Shitovdm/diploma/images/board.png

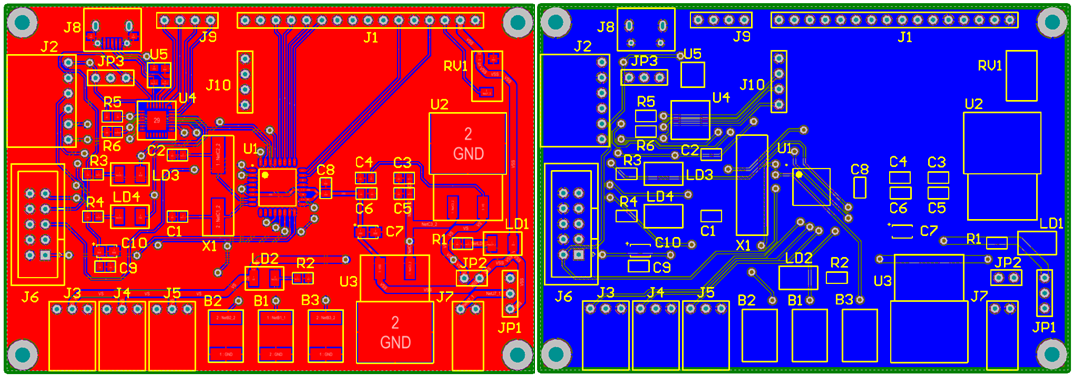
images/board.png
