Shitovdm/diploma/images/hardware/IMG_0107.JPG

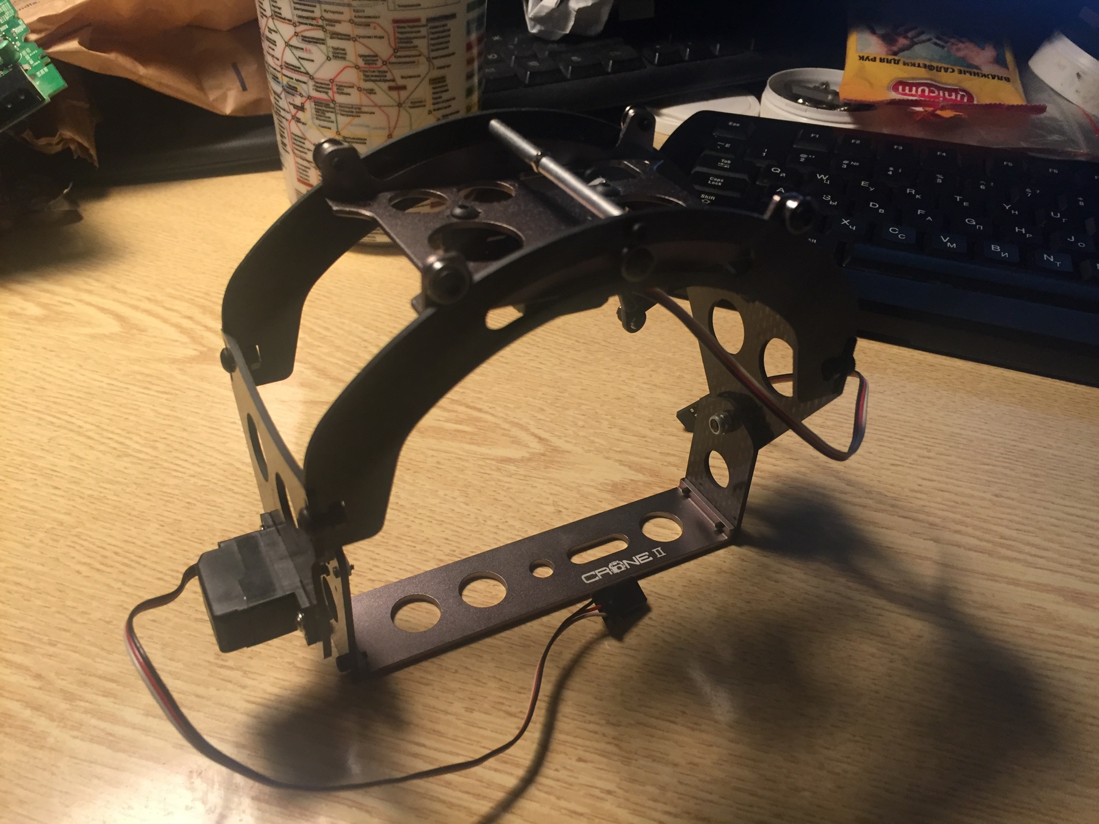
images/hardware/IMG_0107.JPG
