Shitovdm/diploma/images/hardware/IMG_1047.JPG

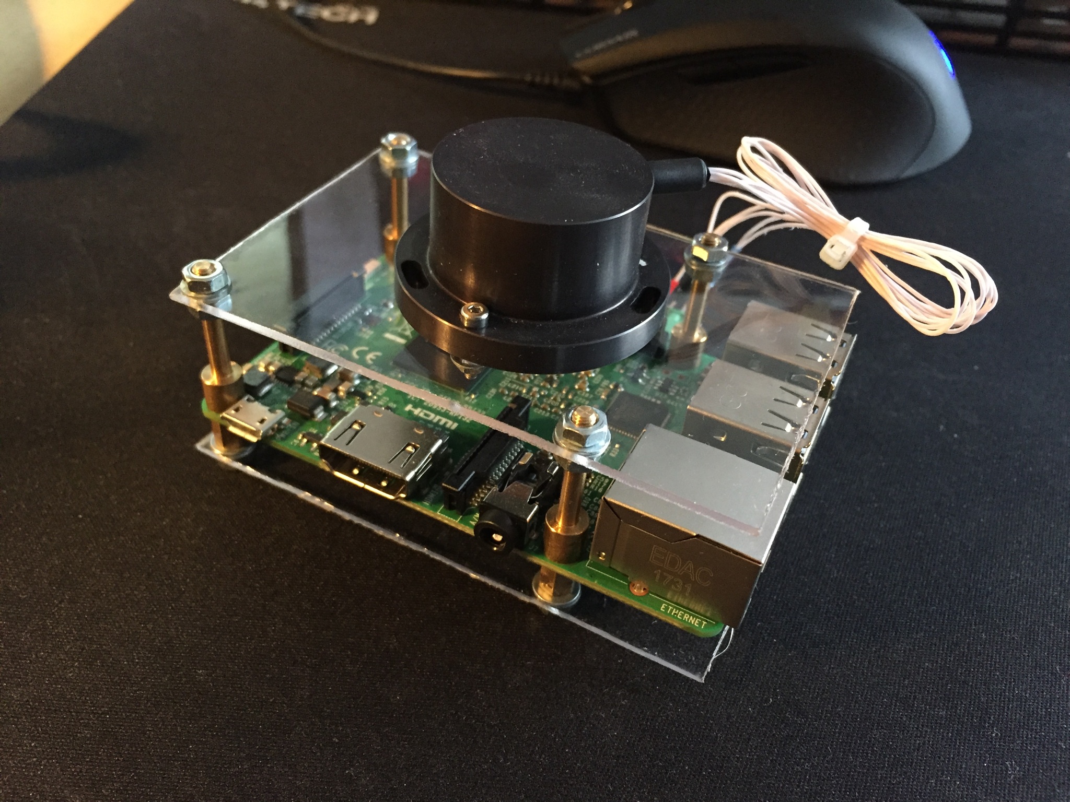
images/hardware/IMG_1047.JPG
