Shitovdm/diploma/images/hardware/IMG_1049.JPG

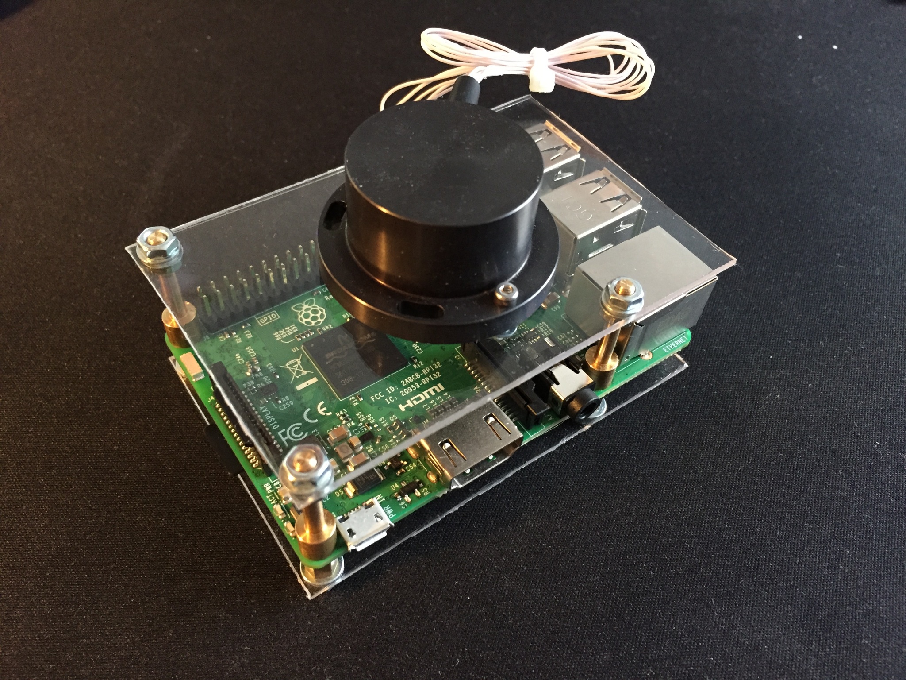
images/hardware/IMG_1049.JPG
