Shitovdm/diploma/images/hardware/IMG_1051.JPG

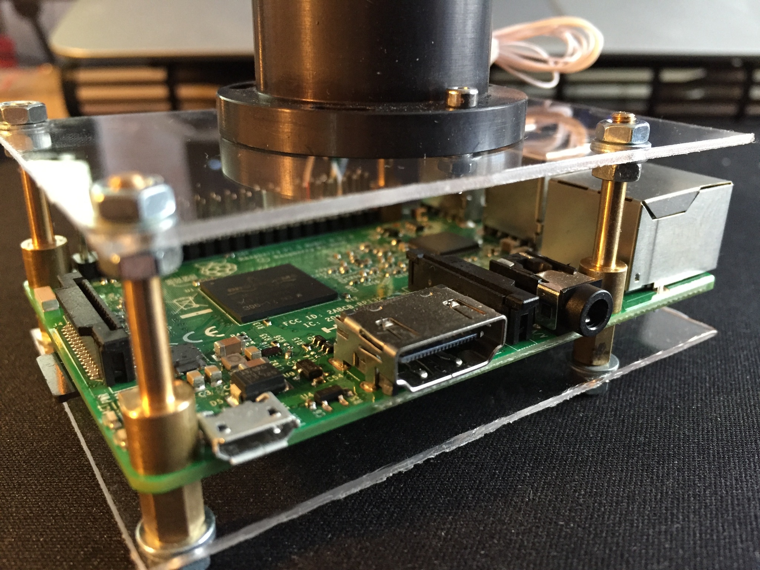
images/hardware/IMG_1051.JPG
