Shitovdm/diploma/images/hardware/IMG_1052.JPG

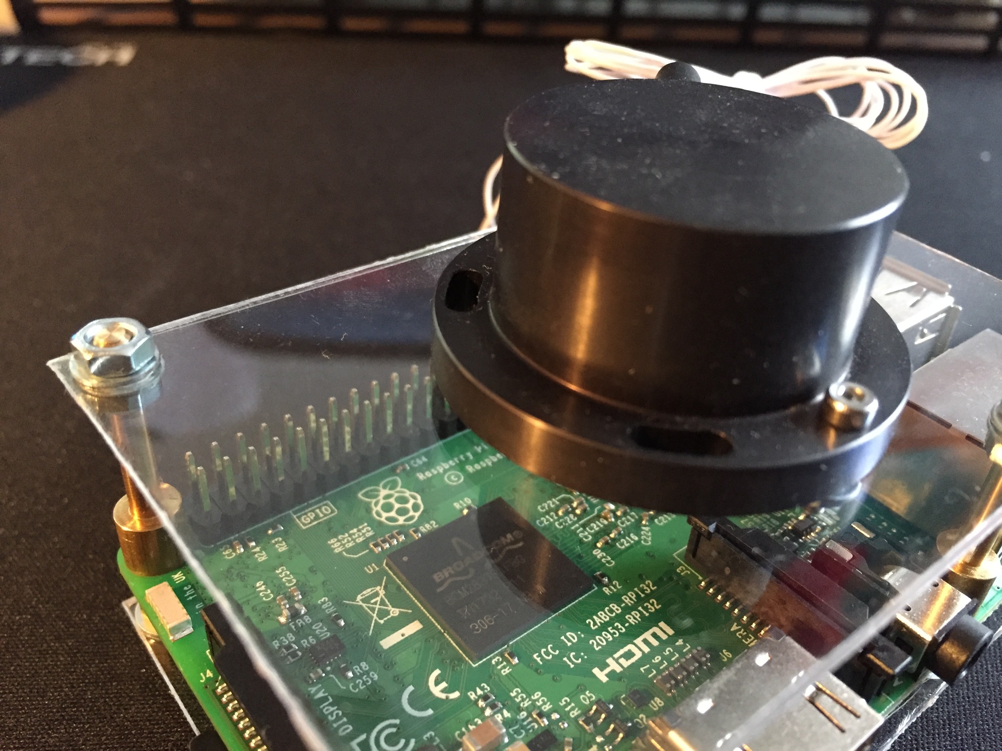
images/hardware/IMG_1052.JPG
