Shitovdm/diploma/images/hardware/IMG_1053.JPG

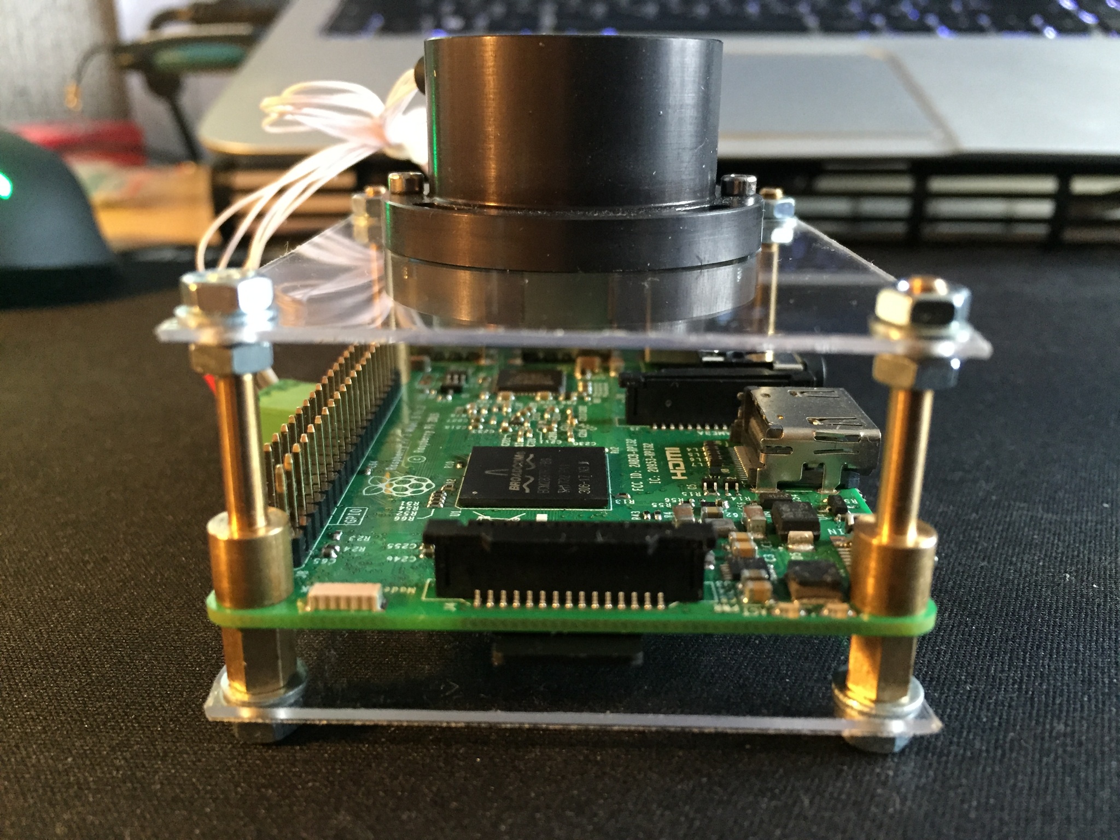
images/hardware/IMG_1053.JPG
