Shitovdm/diploma/images/hardware/IMG_1054.JPG

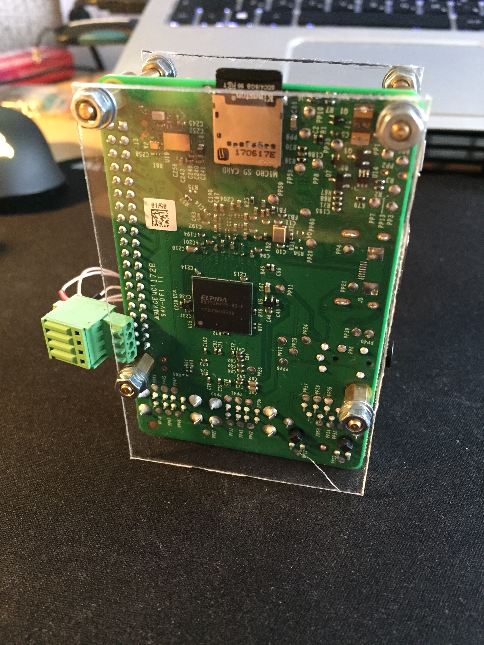
images/hardware/IMG_1054.JPG
