Shitovdm/diploma/images/hardware/IMG_1056.JPG

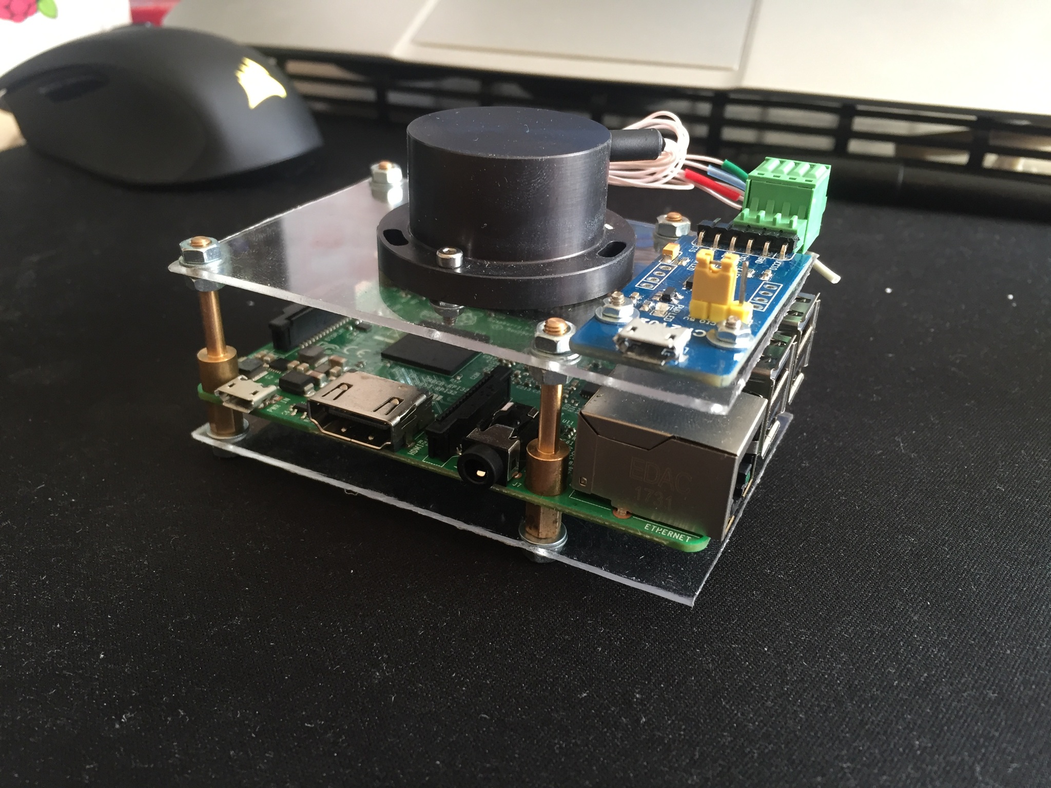
images/hardware/IMG_1056.JPG
