Shitovdm/diploma/images/hardware/IMG_1060.JPG

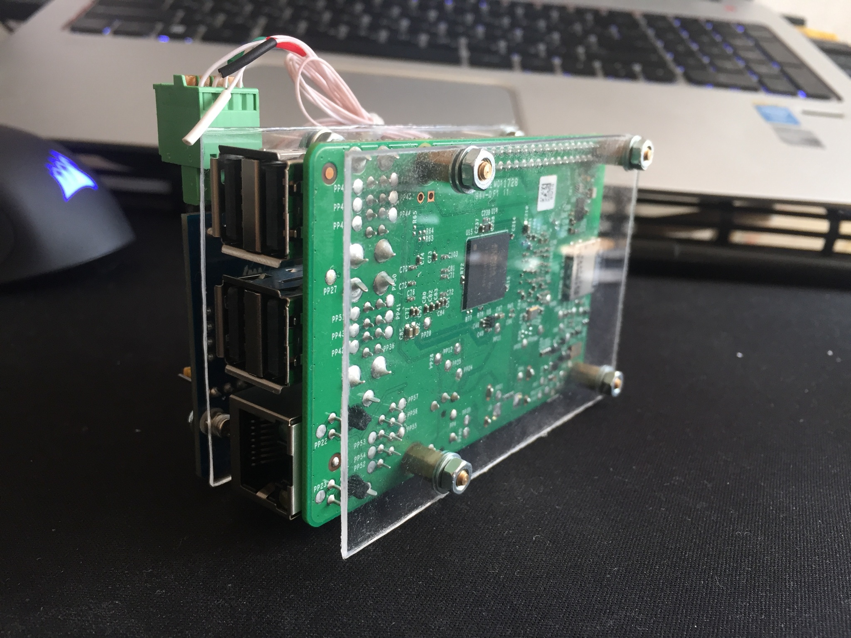
images/hardware/IMG_1060.JPG
