Shitovdm/diploma/images/hardware/IMG_1111.JPG

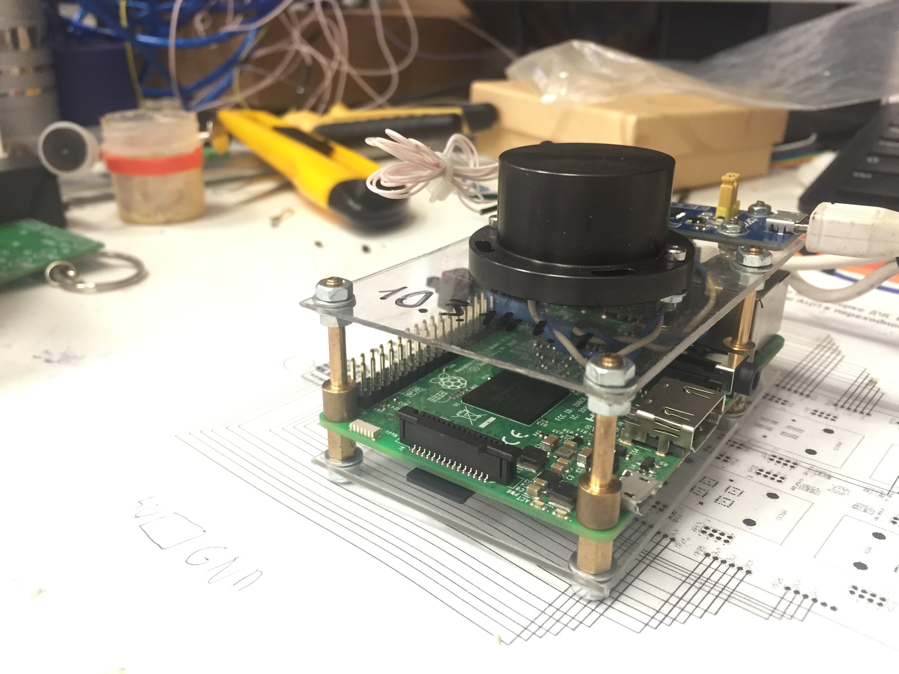
images/hardware/IMG_1111.JPG
