Shitovdm/diploma/images/scheme.PNG

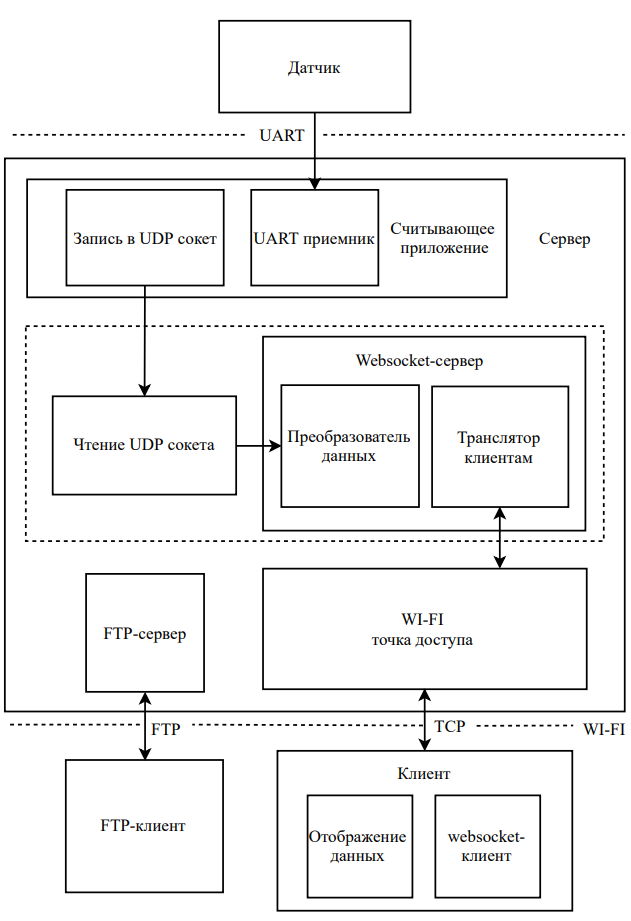
images/scheme.PNG
