Shitovdm/diploma/images/software/black-2.PNG

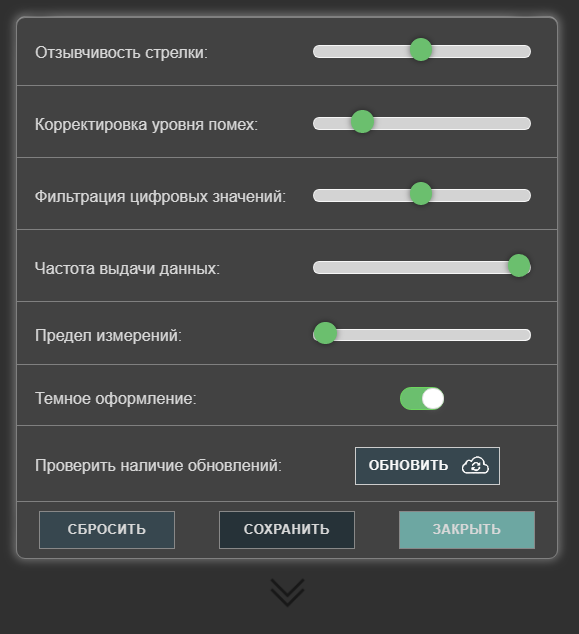
images/software/black-2.PNG
