Shitovdm/diploma/images/software/black-3.PNG

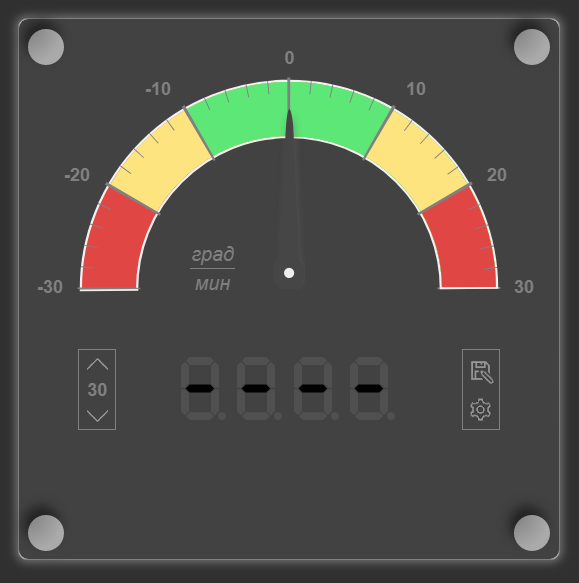
images/software/black-3.PNG
