Shitovdm/diploma/images/software/update.PNG

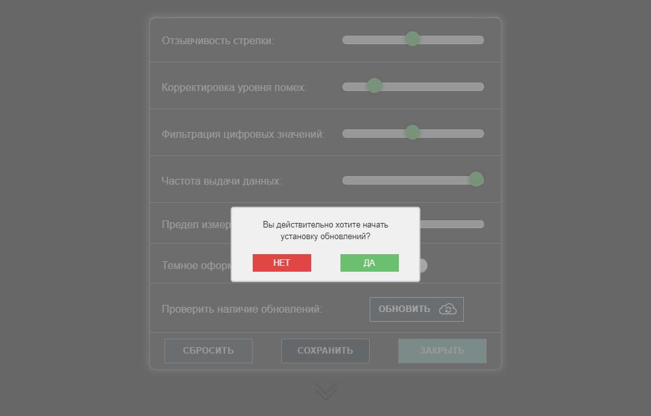
images/software/update.PNG
