Shitovdm/diploma/images/software/white-2.PNG

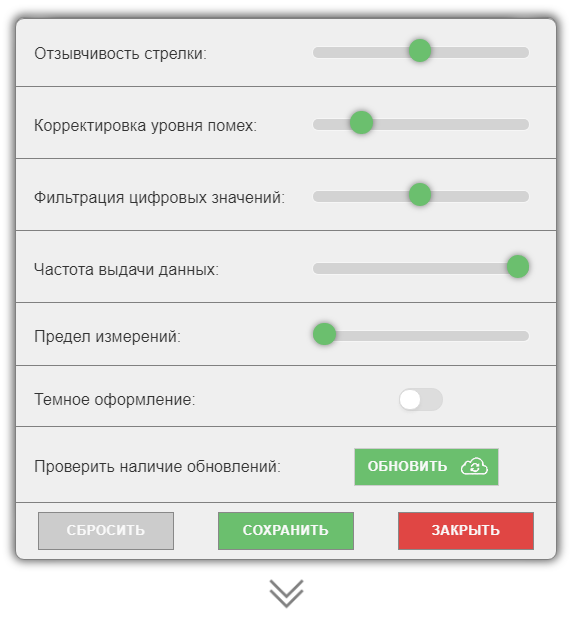
images/software/white-2.PNG
