Shitovdm/diploma/images/software/white-3.PNG

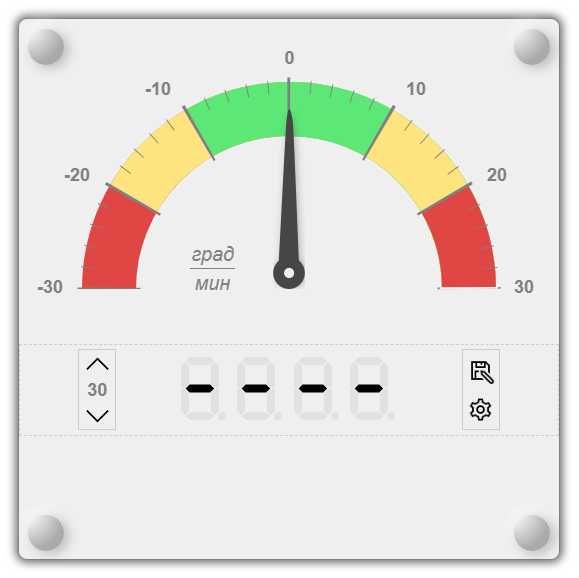
images/software/white-3.PNG
