Shitovdm/diploma/src/service/img/client-r.png

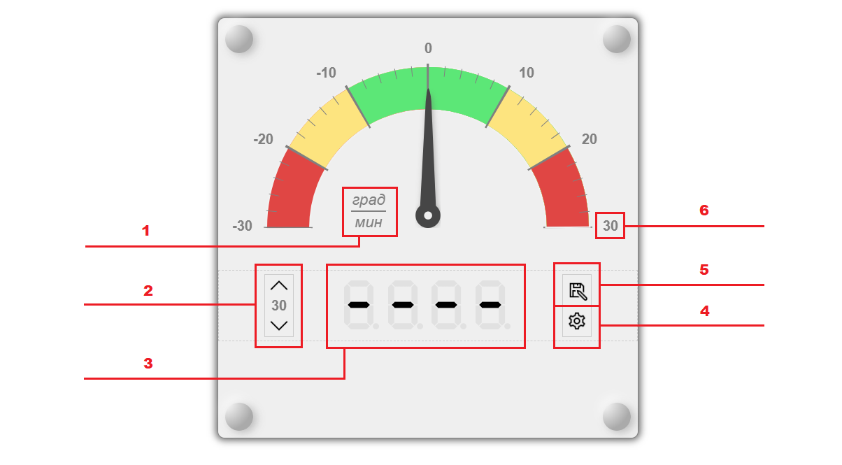
src/service/img/client-r.png
