Shitovdm/diploma/src/service/img/client.PNG

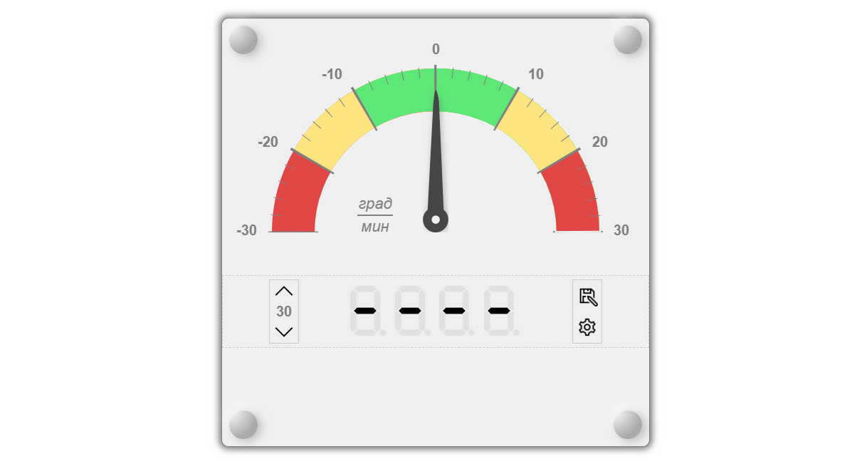
src/service/img/client.PNG
