Shitovdm/diploma/Altium/3D models/micro_usb_connector.stp

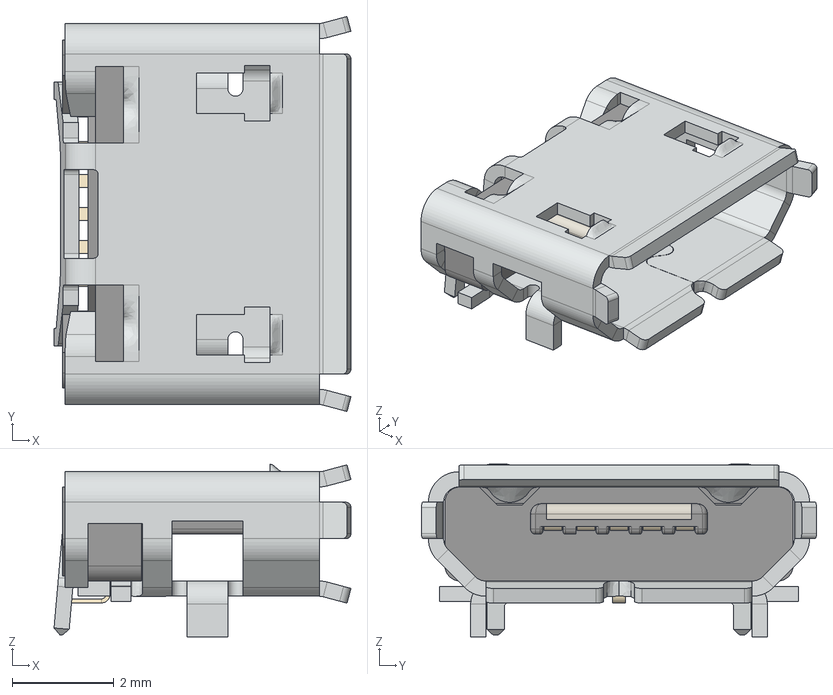
[picture p108: CAD file, 2017-12-09, last stored version]
Altium/3D models/micro_usb_connector.stp
5.84 x 7.77 x 3.40 mm
shield
socket_housing
socket_plate
terminal x 5
