Shitovdm/diploma/Altium/3D models/Разные 3D модели/Capacitors/CAPAE-D8.0x6.2.stp

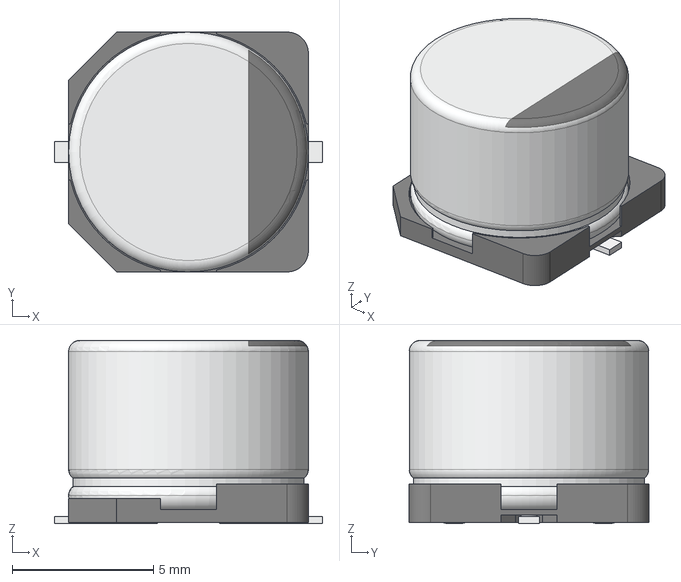
[picture p109: CAD file, 2017-12-06, last stored version]
Altium/3D models/Разные 3D модели/Capacitors/CAPAE-D8.0x6.2.stp
9.50 x 8.50 x 6.50 mm
