Shitovdm/diploma/Altium/3D models/Разные 3D модели/Crystals/HC-49SM.stp

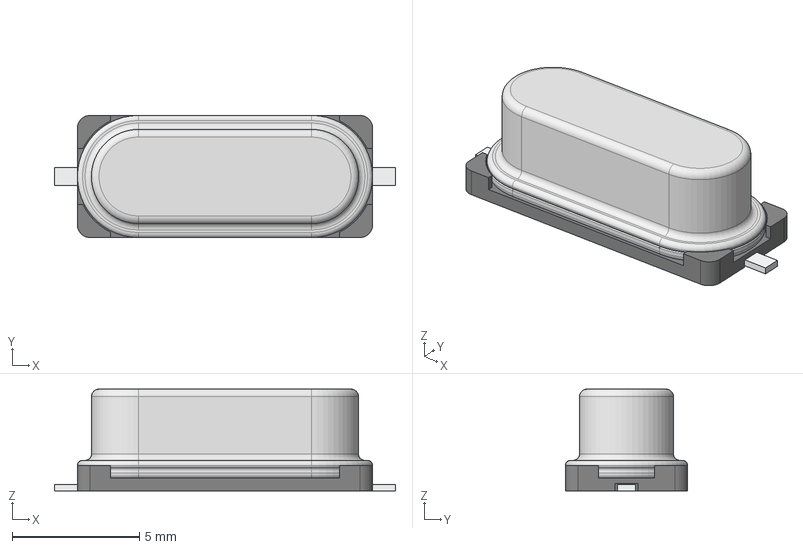
[picture p110: CAD file, 2017-12-06, last stored version]
Altium/3D models/Разные 3D модели/Crystals/HC-49SM.stp
13.4 x 4.80 x 4.00 mm
