Shitovdm/diploma/Altium/3D models/Разные 3D модели/DIP_sockets/DIP300-skt-flat-14.stp

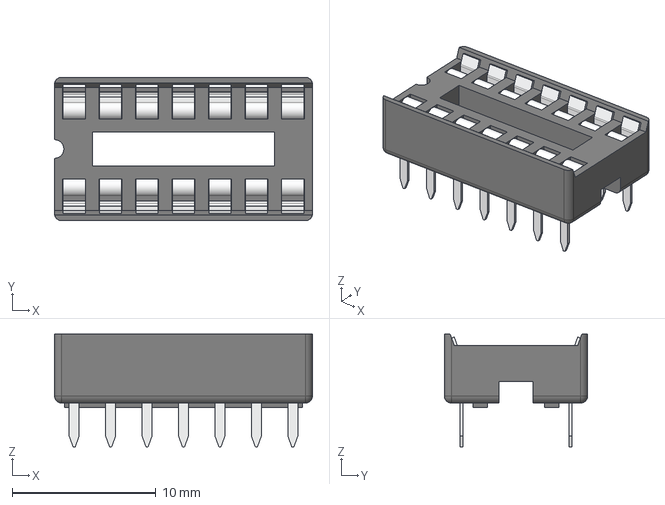
[picture p111: CAD file, 2017-12-06, last stored version]
Altium/3D models/Разные 3D модели/DIP_sockets/DIP300-skt-flat-14.stp
18.0 x 10.0 x 7.85 mm
