Shitovdm/diploma/Altium/3D models/Разные 3D модели/discrete-smd-1.snapshot.88/custom/TI_DCQ_R-PDSO-G6.stp

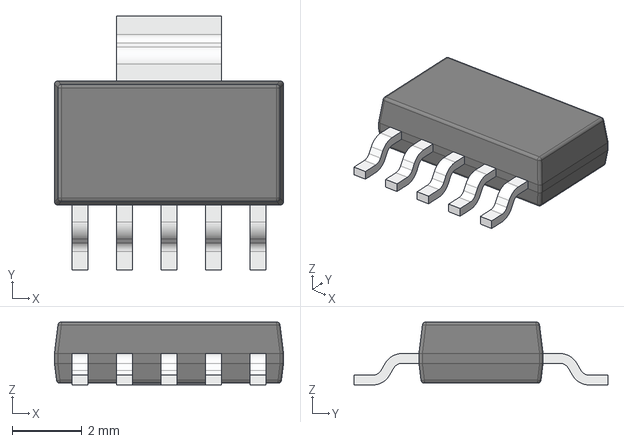
[picture p112: CAD file, 2017-12-06, last stored version]
Altium/3D models/Разные 3D модели/discrete-smd-1.snapshot.88/custom/TI_DCQ_R-PDSO-G6.stp
6.55 x 7.26 x 1.80 mm
