Shitovdm/diploma/Altium/3D models/Разные 3D модели/discrete-smd-1.snapshot.88/SC-76.stp

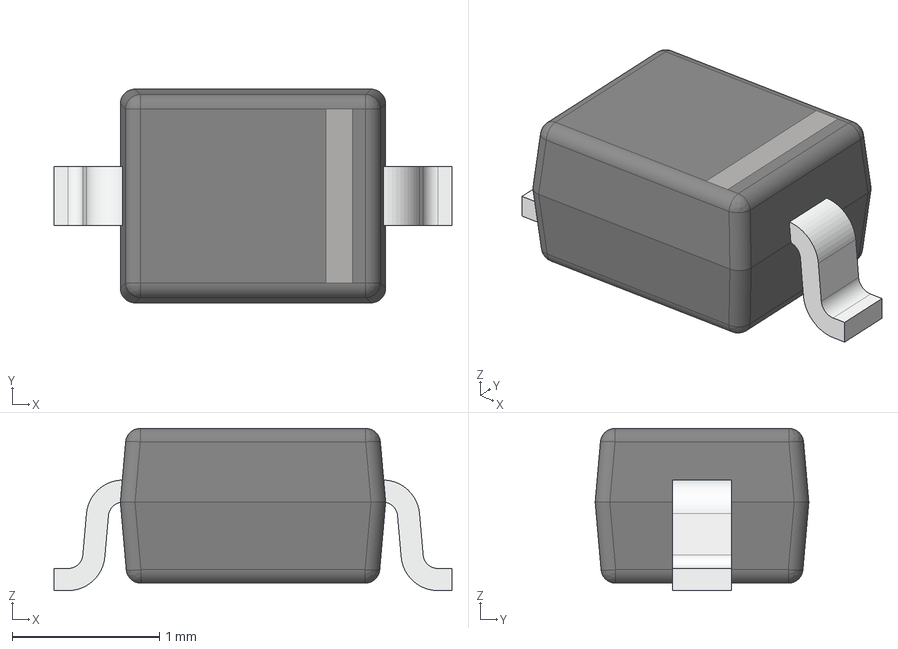
[picture p113: CAD file, 2017-12-06, last stored version]
Altium/3D models/Разные 3D модели/discrete-smd-1.snapshot.88/SC-76.stp
2.70 x 1.45 x 1.10 mm
