Shitovdm/diploma/Altium/3D models/Разные 3D модели/Inductors/SRP1038A-LF.stp

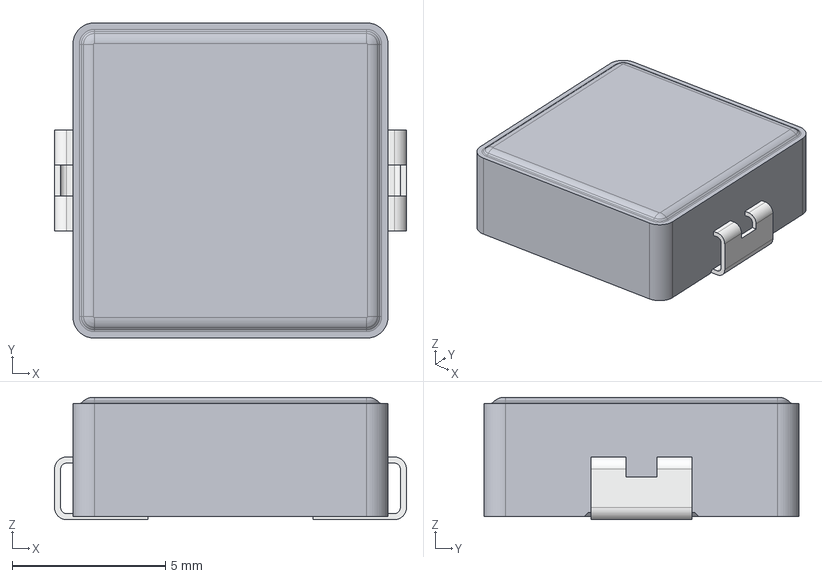
[picture p114: CAD file, 2017-12-06, last stored version]
Altium/3D models/Разные 3D модели/Inductors/SRP1038A-LF.stp
11.5 x 10.3 x 4.00 mm
