Shitovdm/diploma/Altium/3D models/Разные 3D модели/rectangular/direct_wire/2.54mm/DS1018-106B.stp

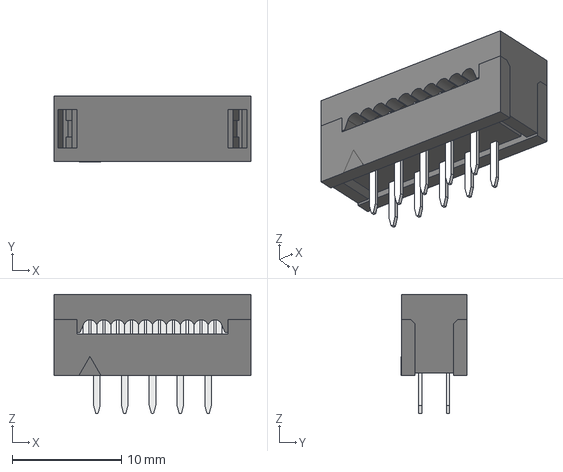
[picture p115: CAD file, 2017-12-06, last stored version]
Altium/3D models/Разные 3D модели/rectangular/direct_wire/2.54mm/DS1018-106B.stp
18.0 x 6.03 x 10.9 mm
