Shitovdm/diploma/Altium/3D models/Разные 3D модели/rectangular/female/vertical/2.54mm/DS1023-2x7SF11.stp

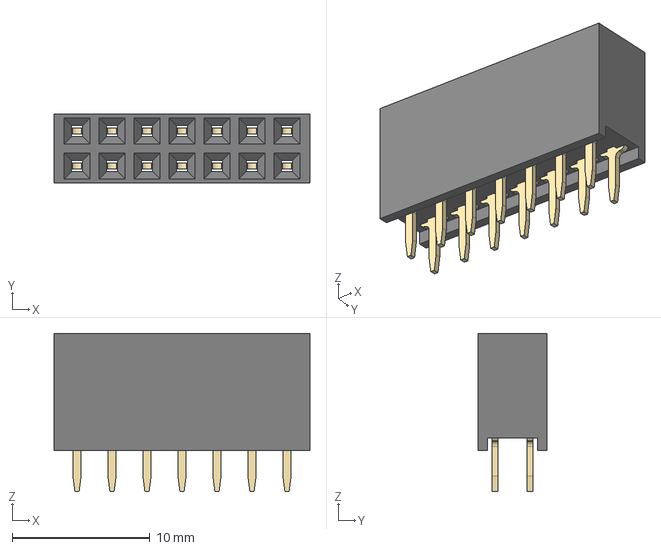
[picture p117: CAD file, 2017-12-06, last stored version]
Altium/3D models/Разные 3D модели/rectangular/female/vertical/2.54mm/DS1023-2x7SF11.stp
18.6 x 5.00 x 11.5 mm
