Shitovdm/diploma/Altium/3D models/Разные 3D модели/rectangular/female/vertical/2.54mm/Samtec/SL-106-TT-11.stp

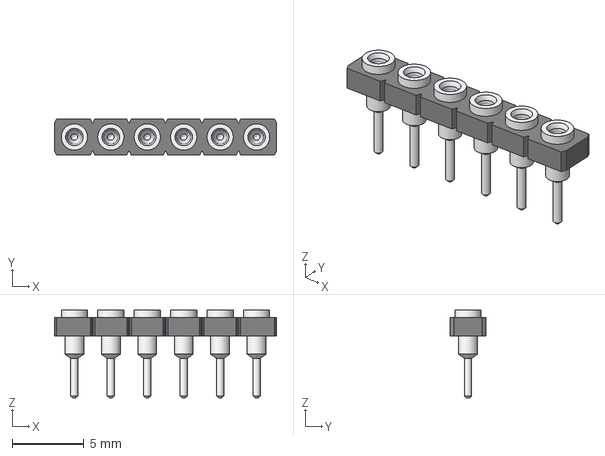
[picture p118: CAD file, 2017-12-06, last stored version]
Altium/3D models/Разные 3D модели/rectangular/female/vertical/2.54mm/Samtec/SL-106-TT-11.stp
15.5 x 2.54 x 6.10 mm
