Shitovdm/diploma/Altium/3D models/Разные 3D модели/rectangular/male/shrouded/right_angle/2.54mm/DS1013-08RSiB.stp

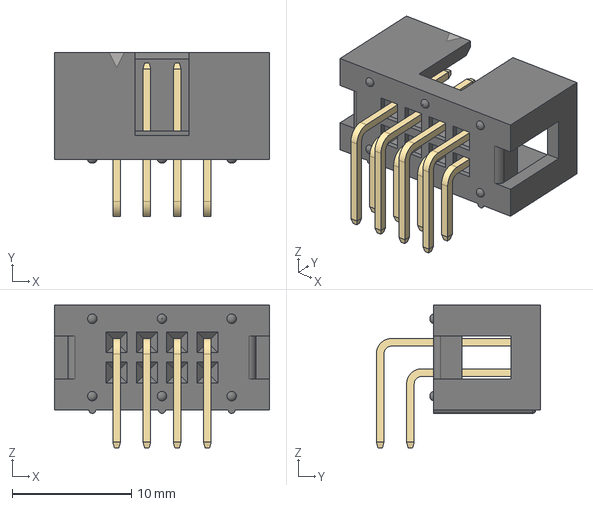
[picture p119: CAD file, 2017-12-06, last stored version]
Altium/3D models/Разные 3D модели/rectangular/male/shrouded/right_angle/2.54mm/DS1013-08RSiB.stp
18.1 x 13.8 x 12.0 mm
