Shitovdm/diploma/Altium/3D models/Разные 3D модели/rectangular/male/unshrouded/right_angle/2.54mm/DS1022-1x10RDF11.stp

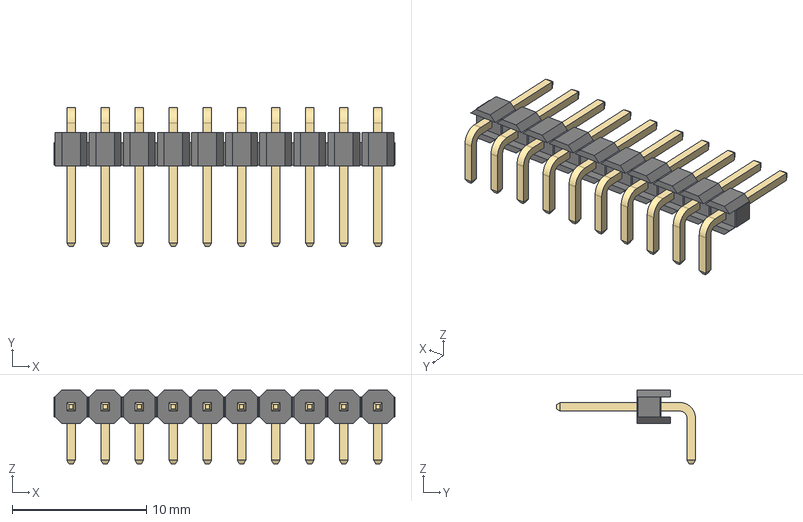
[picture p123: CAD file, 2017-12-06, last stored version]
Altium/3D models/Разные 3D модели/rectangular/male/unshrouded/right_angle/2.54mm/DS1022-1x10RDF11.stp
25.4 x 10.4 x 5.50 mm
