Shitovdm/diploma/Altium/3D models/Разные 3D модели/rectangular/male/unshrouded/vertical/1.27mm/DS1031-01-1x1P8BV2-1.stp

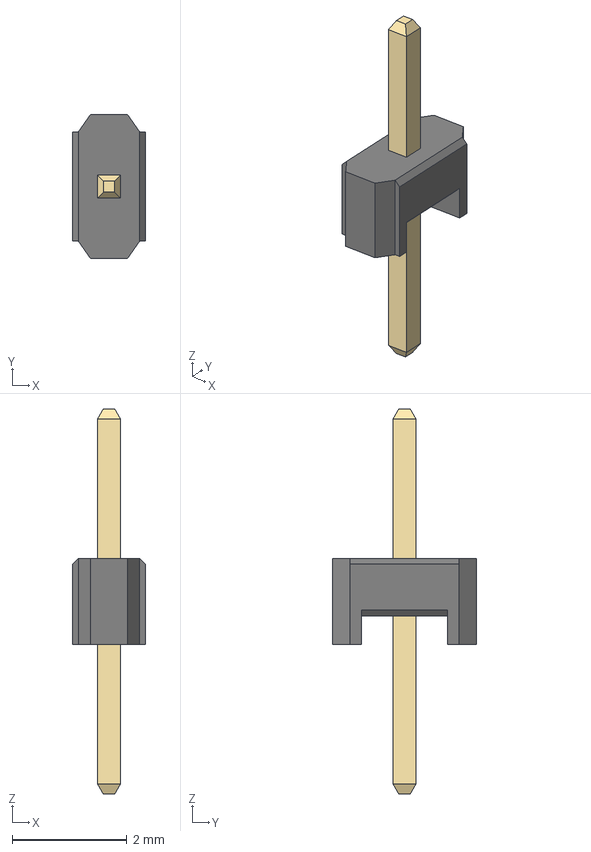
[picture p124: CAD file, 2017-12-06, last stored version]
Altium/3D models/Разные 3D модели/rectangular/male/unshrouded/vertical/1.27mm/DS1031-01-1x1P8BV2-1.stp
1.27 x 2.50 x 6.70 mm
