Shitovdm/diploma/Altium/3D models/Разные 3D модели/rectangular/male/unshrouded/vertical/2.54mm/DS1070-4MVV6.stp

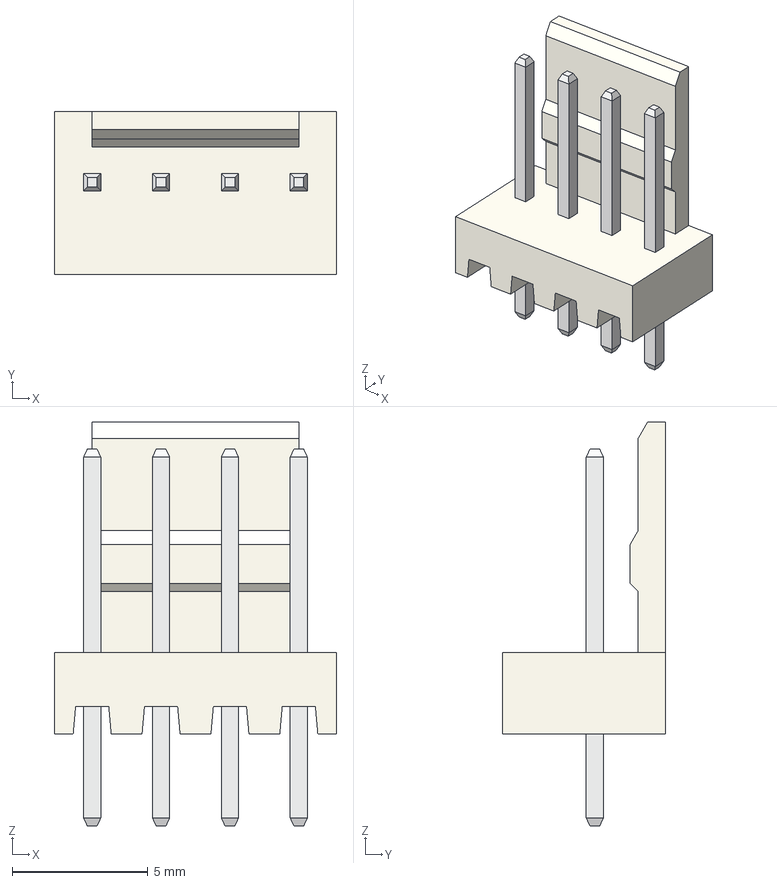
[picture p125: CAD file, 2017-12-06, last stored version]
Altium/3D models/Разные 3D модели/rectangular/male/unshrouded/vertical/2.54mm/DS1070-4MVV6.stp
10.4 x 6.00 x 14.9 mm
