Shitovdm/diploma/Altium/3D models/Разные 3D модели/Resistors/CAT16-J2.stp

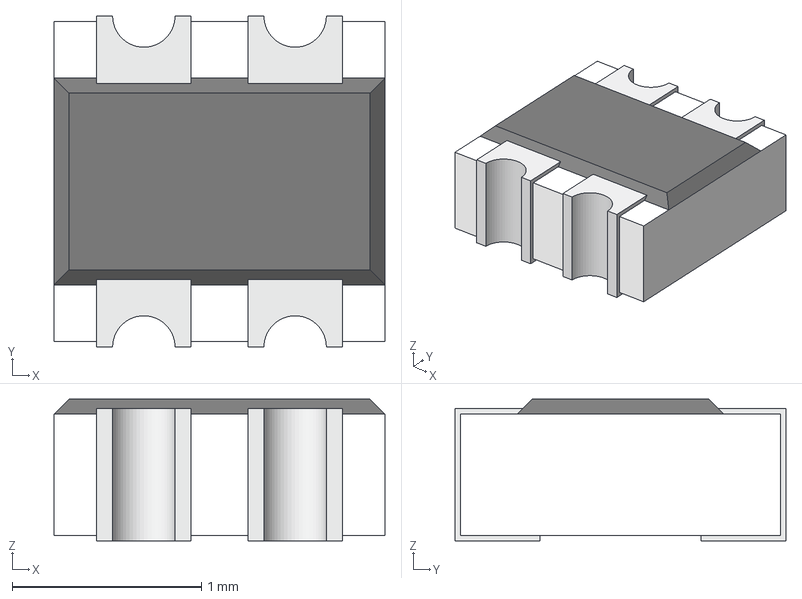
[picture p126: CAD file, 2017-12-06, last stored version]
Altium/3D models/Разные 3D модели/Resistors/CAT16-J2.stp
1.75 x 1.75 x 0.75 mm
