Shitovdm/diploma/Altium/diploma/Project Outputs for diploma/AutoCAD SCH/Scheme.dxf

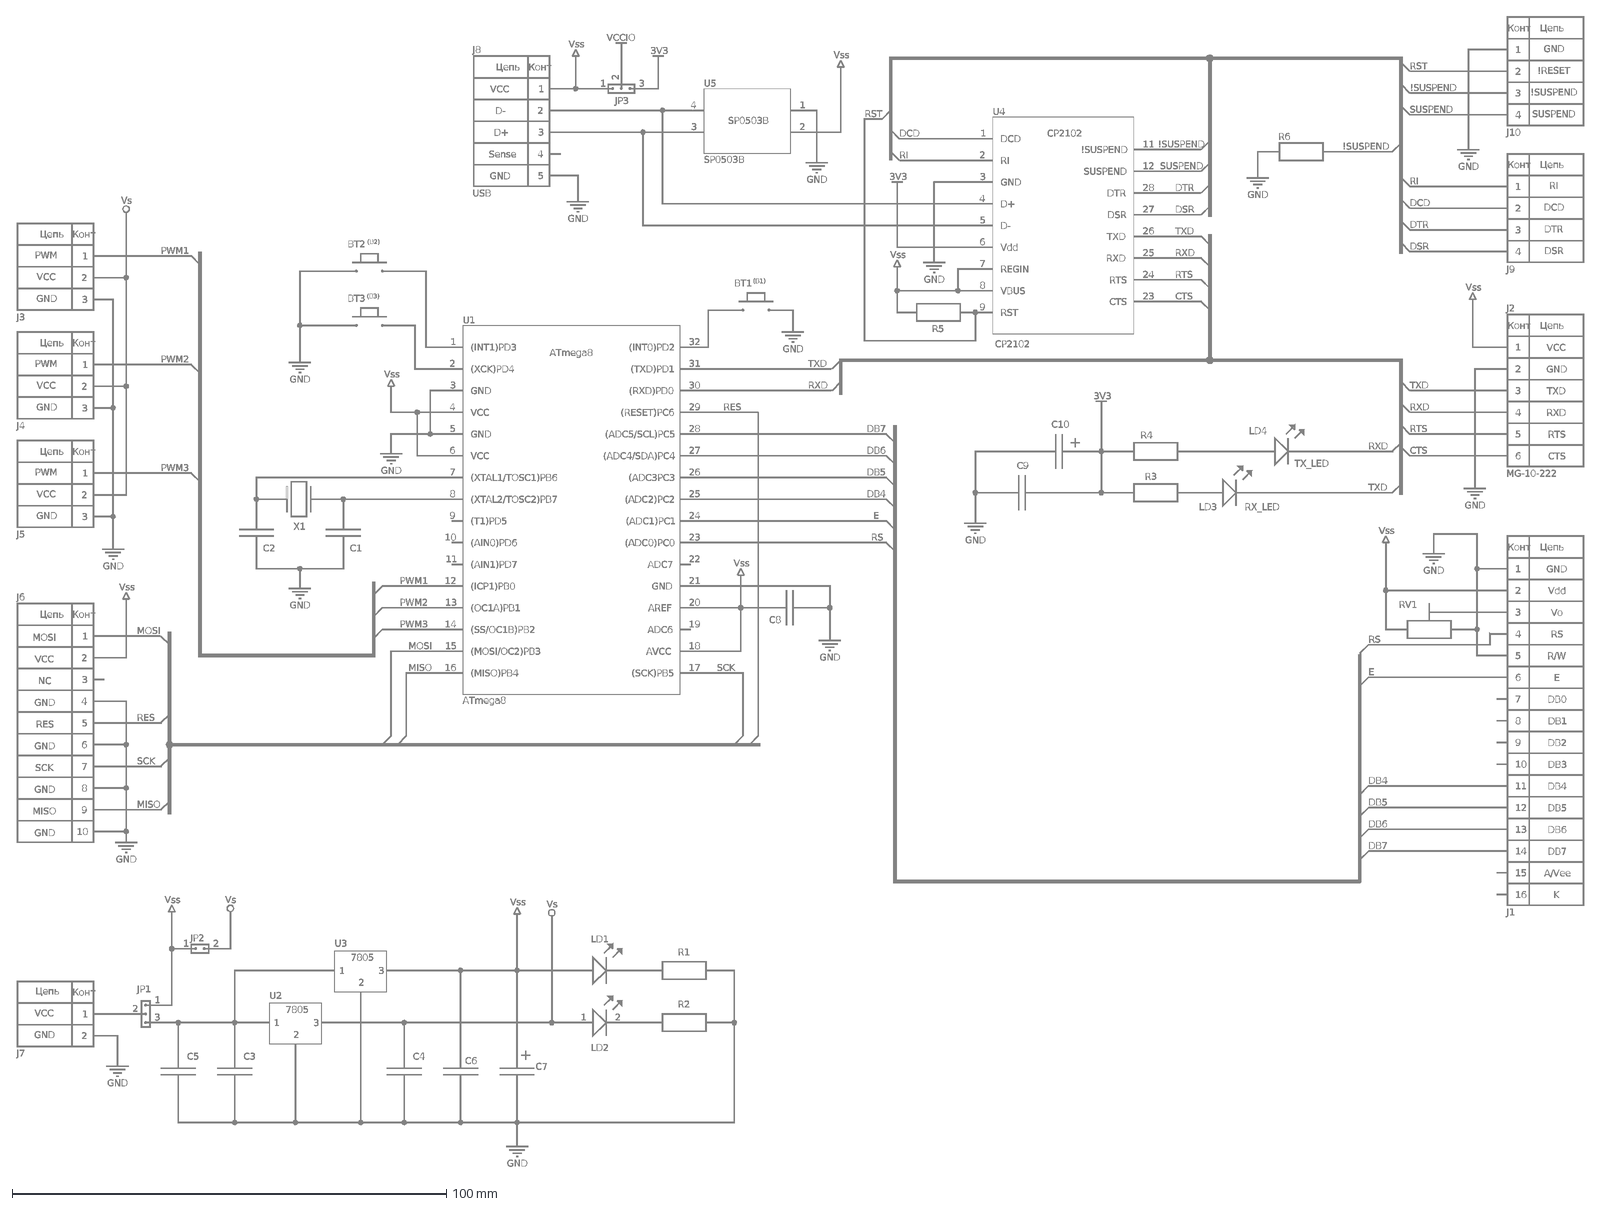
[picture p127: CAD file, 2017-12-10, last stored version]
Altium/diploma/Project Outputs for diploma/AutoCAD SCH/Scheme.dxf
(XTAL1/TOSC1)PB6
7
GND
5
(INT1)PD3
1
(XCK)PD4
2
(XTAL2/TOSC2)PB7
8
VCC
6
3
4
(SCK)PB5
17
ATmega8
(T1)PD5
9
(AIN0)PD6
10
(AIN1)PD7
11
(ICP1)PB0
12
(OC1A)PB1
13
(SS/OC1B)PB2
14
(MOSI/OC2)PB3
15
(MISO)PB4
16
AVCC
18
ADC6
19
AREF
20
21
ADC7
22
(ADC0)PC0
23
(ADC1)PC1
24
(ADC2)PC2
25
(ADC3PC3
26
(ADC4/SDA)PC4
27
(ADC5/SCL)PC5
28
(RESET)PC6
29
(RXD)PD0
30
(TXD)PD1
31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
