Shitovdm/diploma/Altium/3D models/QFN-28 5x5mm.stp

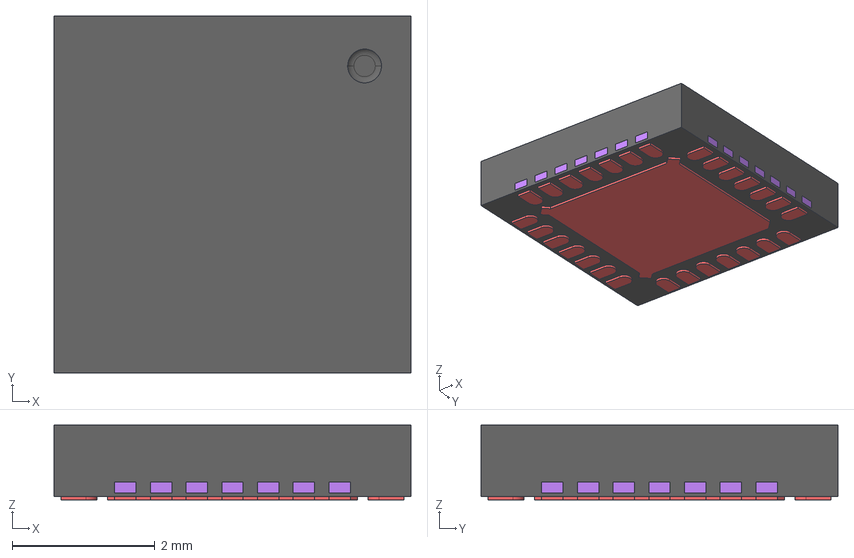
[picture p128: CAD file, 2017-12-09, last stored version]
Altium/3D models/QFN-28 5x5mm.stp
5.00 x 5.00 x 1.05 mm
