Shitovdm/diploma/Altium/3D models/Разные 3D модели/Capacitors/CAPAE-D10.0x10.2.stp

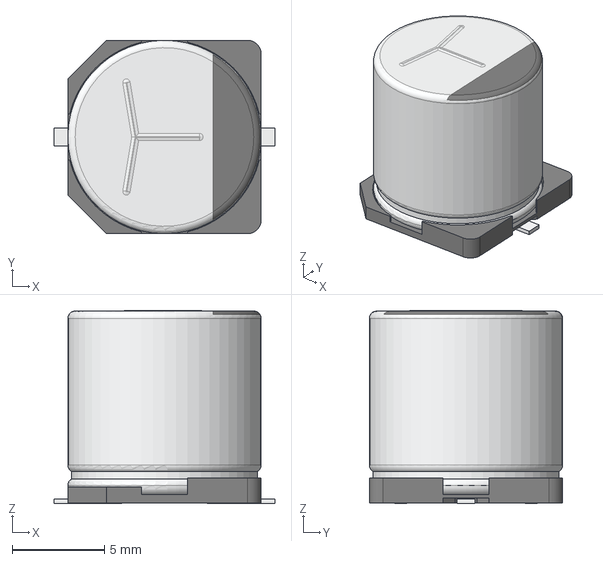
[picture p129: CAD file, 2017-12-06, last stored version]
Altium/3D models/Разные 3D модели/Capacitors/CAPAE-D10.0x10.2.stp
12.0 x 10.5 x 10.5 mm
