Shitovdm/diploma/Altium/3D models/Разные 3D модели/discrete-smd-1.snapshot.88/DO-214AB.stp

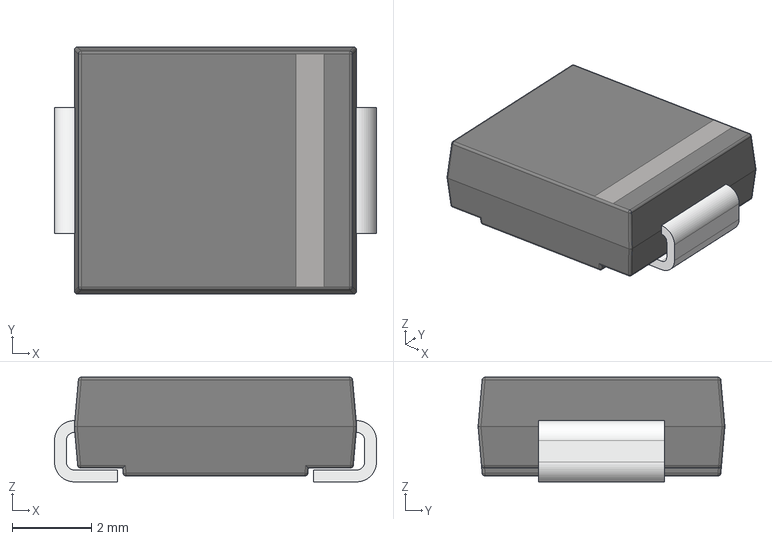
[picture p131: CAD file, 2017-12-06, last stored version]
Altium/3D models/Разные 3D модели/discrete-smd-1.snapshot.88/DO-214AB.stp
8.15 x 6.25 x 2.65 mm
