Shitovdm/diploma/Altium/3D models/Разные 3D модели/Inductors/LPS4018.stp

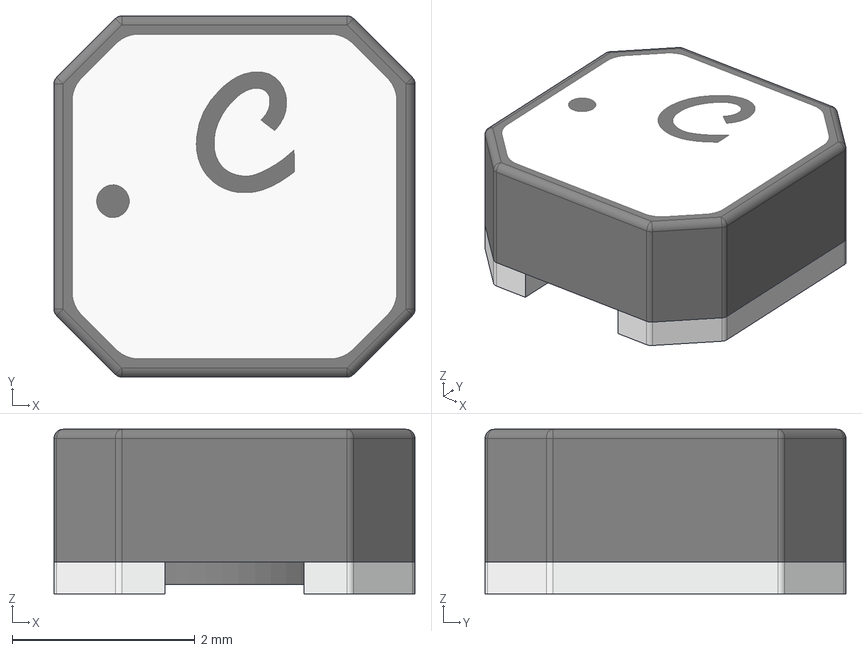
[picture p132: CAD file, 2017-12-06, last stored version]
Altium/3D models/Разные 3D модели/Inductors/LPS4018.stp
3.95 x 3.95 x 1.80 mm
