Shitovdm/diploma/Altium/3D models/Разные 3D модели/rectangular/direct_wire/2.54mm/DS1018-146B.stp

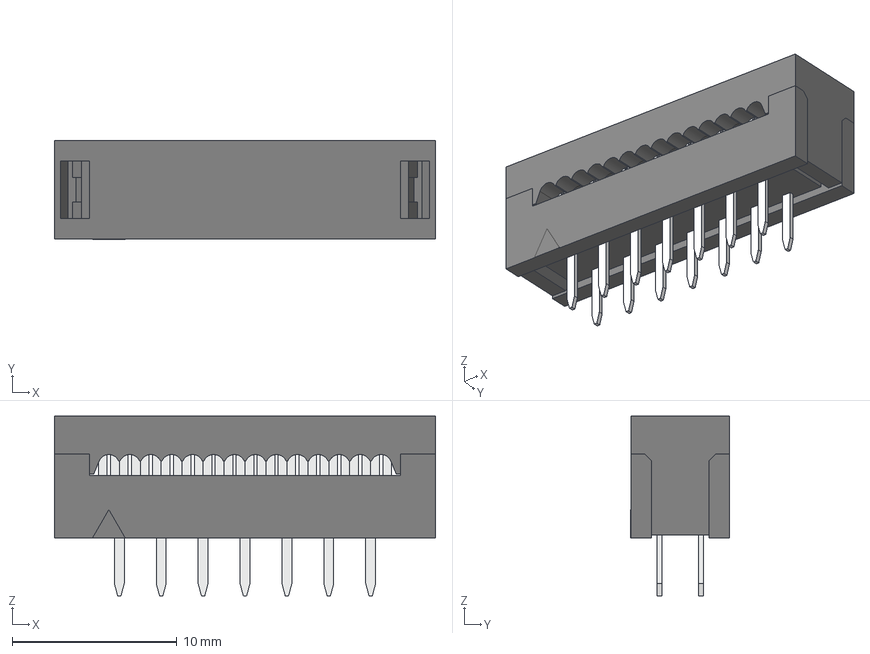
[picture p133: CAD file, 2017-12-06, last stored version]
Altium/3D models/Разные 3D модели/rectangular/direct_wire/2.54mm/DS1018-146B.stp
23.1 x 6.03 x 10.9 mm
