Shitovdm/diploma/Altium/3D models/Разные 3D модели/rectangular/female/right_angle/2.54mm/DS1024-1x4RF1.stp

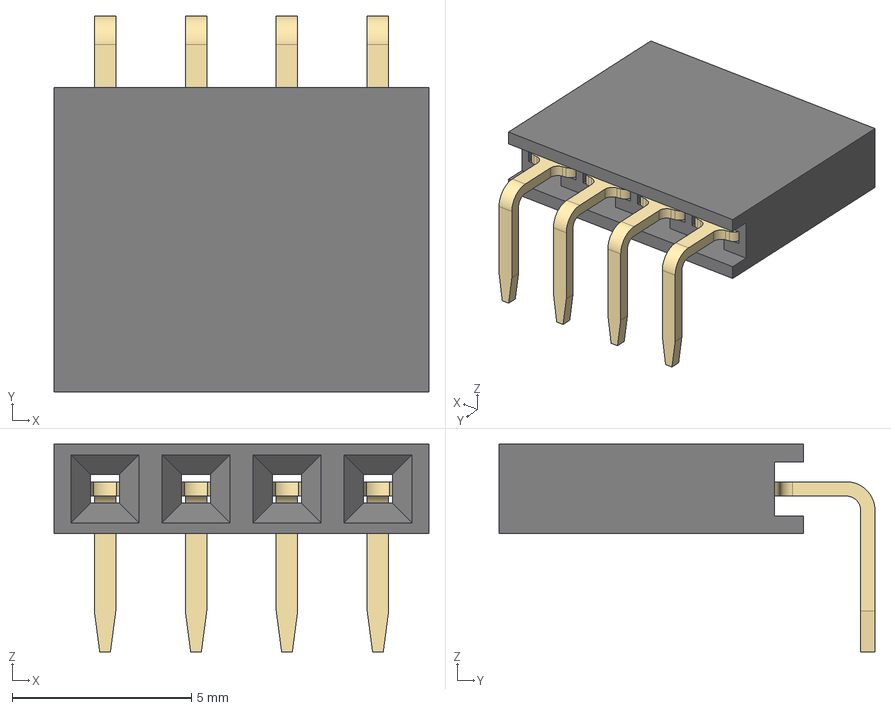
[picture p134: CAD file, 2017-12-06, last stored version]
Altium/3D models/Разные 3D модели/rectangular/female/right_angle/2.54mm/DS1024-1x4RF1.stp
10.5 x 10.5 x 5.80 mm
