Shitovdm/diploma/Altium/3D models/Разные 3D модели/rectangular/female/vertical/2.54mm/DS1023-1x10SF11.stp

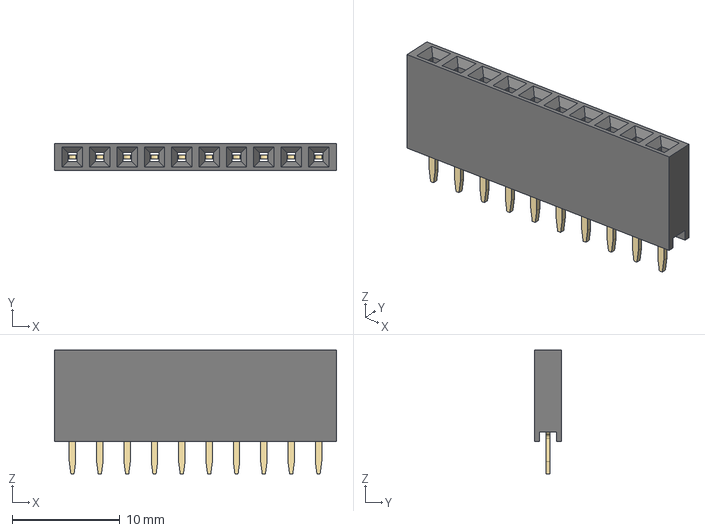
[picture p135: CAD file, 2017-12-06, last stored version]
Altium/3D models/Разные 3D модели/rectangular/female/vertical/2.54mm/DS1023-1x10SF11.stp
26.2 x 2.54 x 11.5 mm
