Shitovdm/diploma/Altium/3D models/Разные 3D модели/rectangular/female/vertical/2.54mm/Samtec/SL-108-TT-10.stp

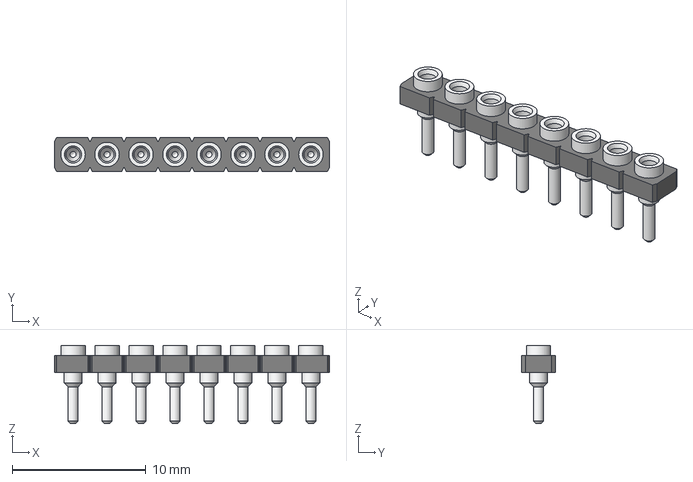
[picture p136: CAD file, 2017-12-06, last stored version]
Altium/3D models/Разные 3D модели/rectangular/female/vertical/2.54mm/Samtec/SL-108-TT-10.stp
20.6 x 2.54 x 5.84 mm
