Shitovdm/diploma/Altium/3D models/Разные 3D модели/rectangular/male/shrouded/right_angle/2.5mm/DS1069-2MRW6XB.stp

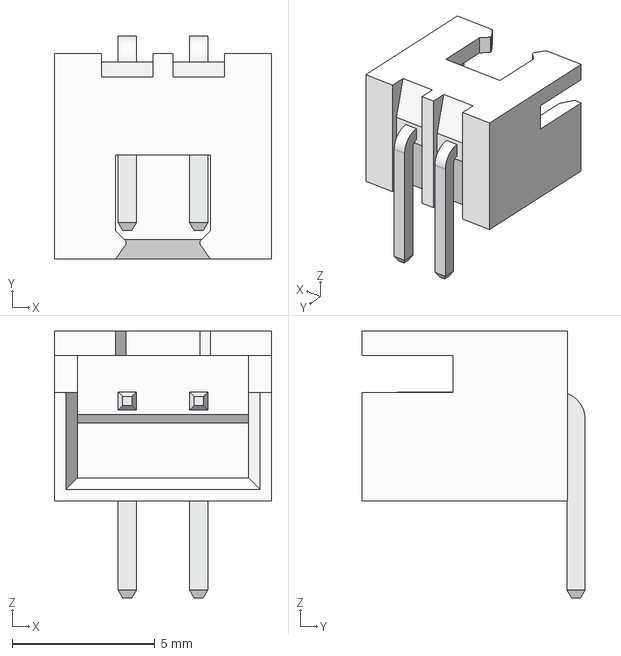
[picture p138: CAD file, 2017-12-06, last stored version]
Altium/3D models/Разные 3D модели/rectangular/male/shrouded/right_angle/2.5mm/DS1069-2MRW6XB.stp
7.60 x 7.82 x 9.35 mm
