Shitovdm/diploma/Altium/3D models/Разные 3D модели/rectangular/male/shrouded/vertical/2.54mm/DS1013-14SSiB.stp

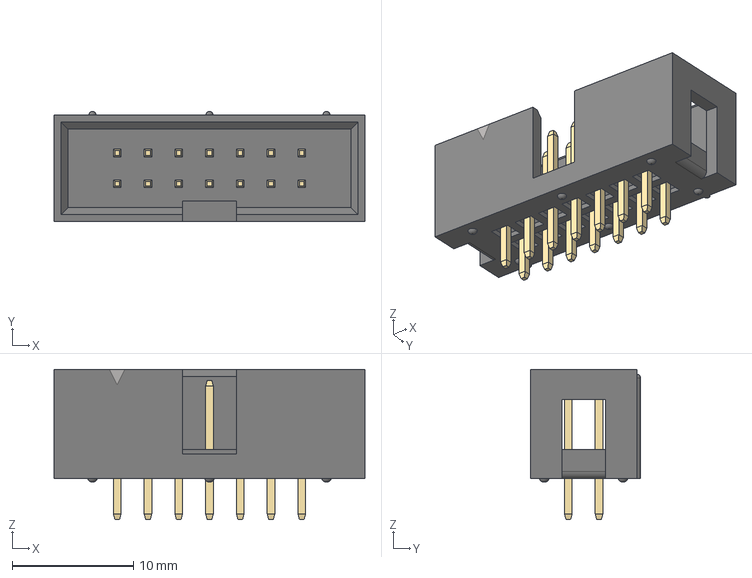
[picture p139: CAD file, 2017-12-06, last stored version]
Altium/3D models/Разные 3D модели/rectangular/male/shrouded/vertical/2.54mm/DS1013-14SSiB.stp
25.7 x 9.10 x 12.4 mm
