Shitovdm/diploma/Altium/3D models/Разные 3D модели/rectangular/male/unshrouded/right_angle/2.54mm/DS1022-1x4RDF11.stp

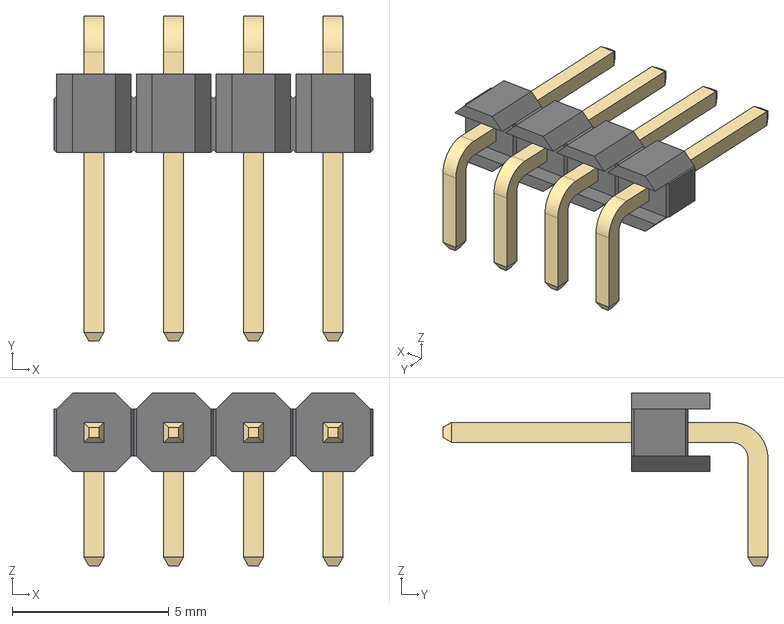
[picture p141: CAD file, 2017-12-06, last stored version]
Altium/3D models/Разные 3D модели/rectangular/male/unshrouded/right_angle/2.54mm/DS1022-1x4RDF11.stp
10.2 x 10.4 x 5.50 mm
