Shitovdm/diploma/Altium/3D models/Разные 3D модели/rectangular/male/unshrouded/vertical/2.54mm/DS1021-1x2SF11.stp

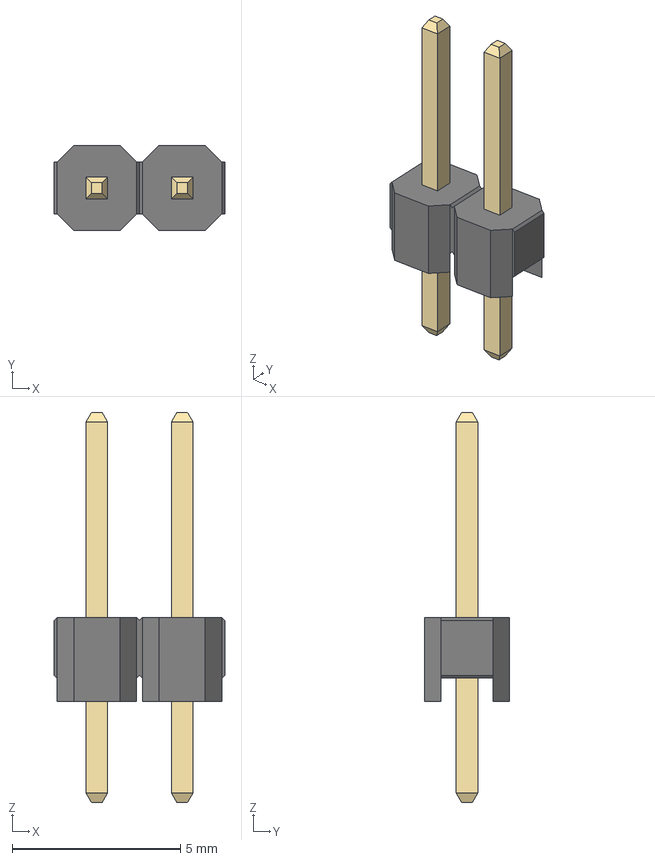
[picture p143: CAD file, 2017-12-06, last stored version]
Altium/3D models/Разные 3D модели/rectangular/male/unshrouded/vertical/2.54mm/DS1021-1x2SF11.stp
5.08 x 2.54 x 11.6 mm
