Shitovdm/diploma/Altium/3D models/Разные 3D модели/Resistors/RESC-1210.stp

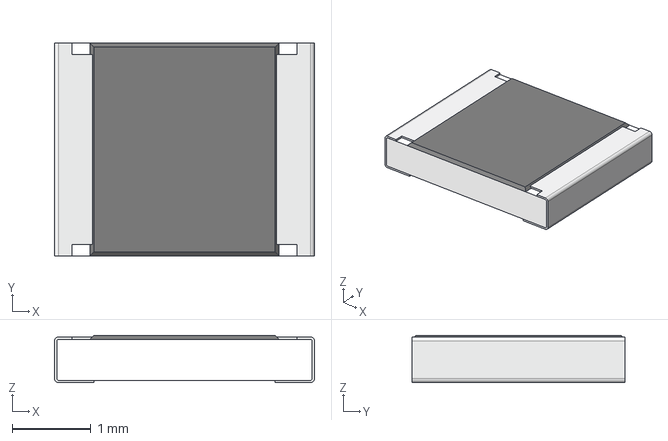
[picture p144: CAD file, 2017-12-06, last stored version]
Altium/3D models/Разные 3D модели/Resistors/RESC-1210.stp
3.30 x 2.70 x 0.6 mm
