Shitovdm/diploma/Altium/3D models/Tactile_SMD_5x5mm.STEP

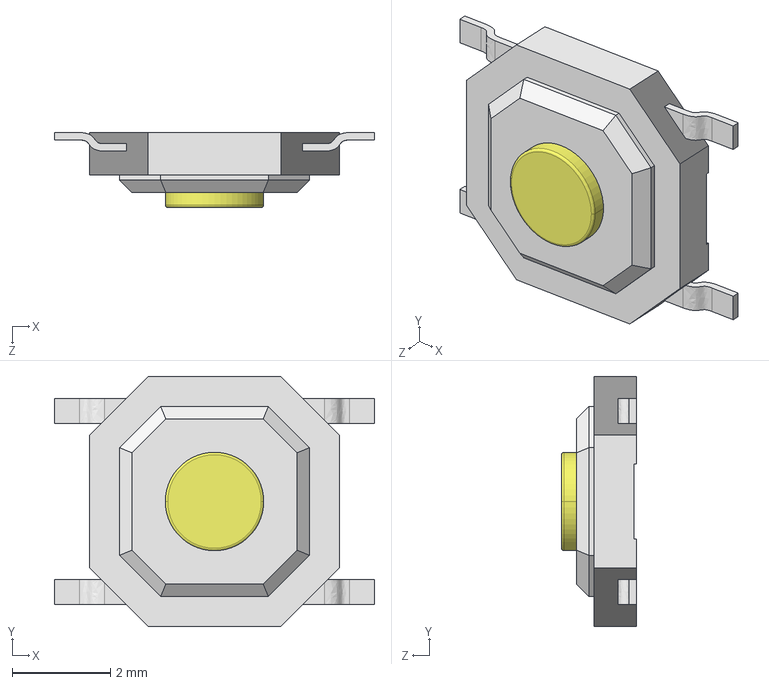
[picture p145: CAD file, 2017-12-06, last stored version]
Altium/3D models/Tactile_SMD_5x5mm.STEP
6.50 x 5.08 x 1.52 mm
