Shitovdm/diploma/Altium/3D models/Разные 3D модели/Capacitors/CAPM-TANTB-YL.stp

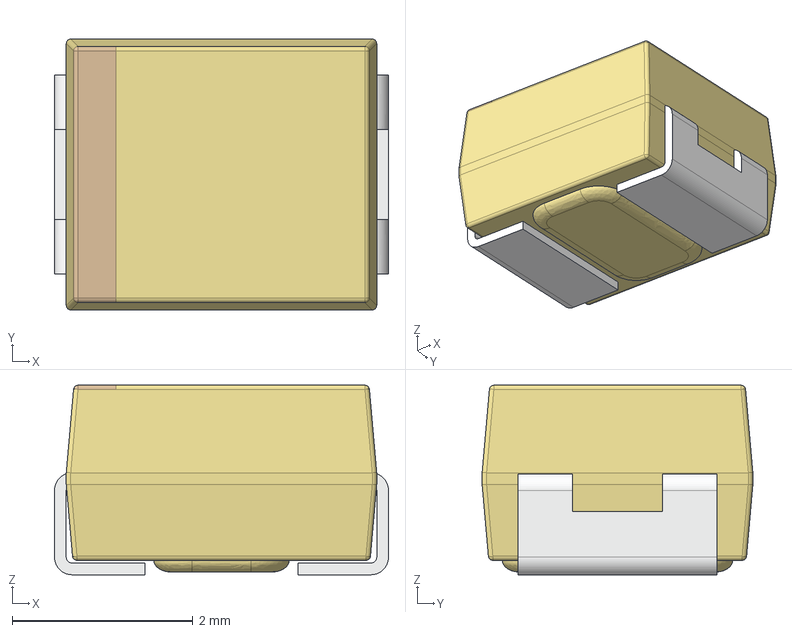
[picture p146: CAD file, 2017-12-06, last stored version]
Altium/3D models/Разные 3D модели/Capacitors/CAPM-TANTB-YL.stp
3.70 x 3.00 x 2.10 mm
