Shitovdm/diploma/Altium/3D models/Разные 3D модели/DIP_sockets/DIP300-skt-flat-20.stp

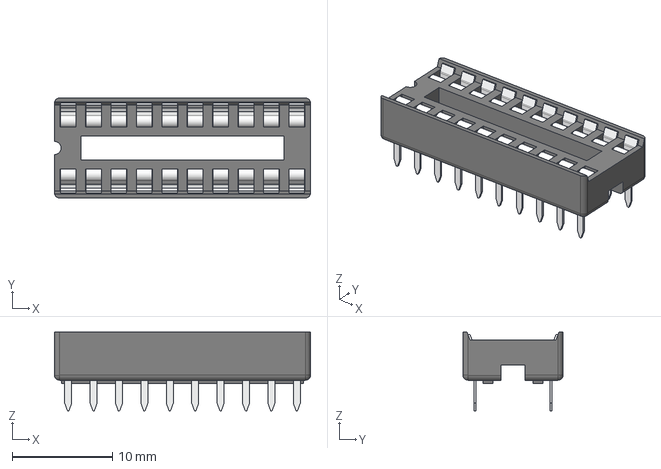
[picture p147: CAD file, 2017-12-06, last stored version]
Altium/3D models/Разные 3D модели/DIP_sockets/DIP300-skt-flat-20.stp
25.6 x 10.0 x 7.85 mm
