Shitovdm/diploma/Altium/3D models/Разные 3D модели/discrete-smd-1.snapshot.88/TO-261AB.stp

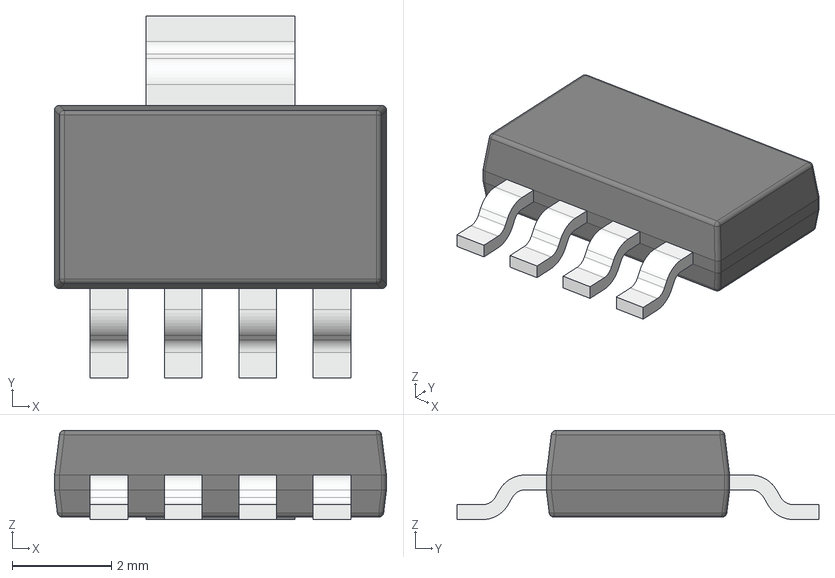
[picture p148: CAD file, 2017-12-06, last stored version]
Altium/3D models/Разные 3D модели/discrete-smd-1.snapshot.88/TO-261AB.stp
6.70 x 7.30 x 1.80 mm
