Shitovdm/diploma/Altium/3D models/Разные 3D модели/Inductors/SRP1038A-NLF.stp

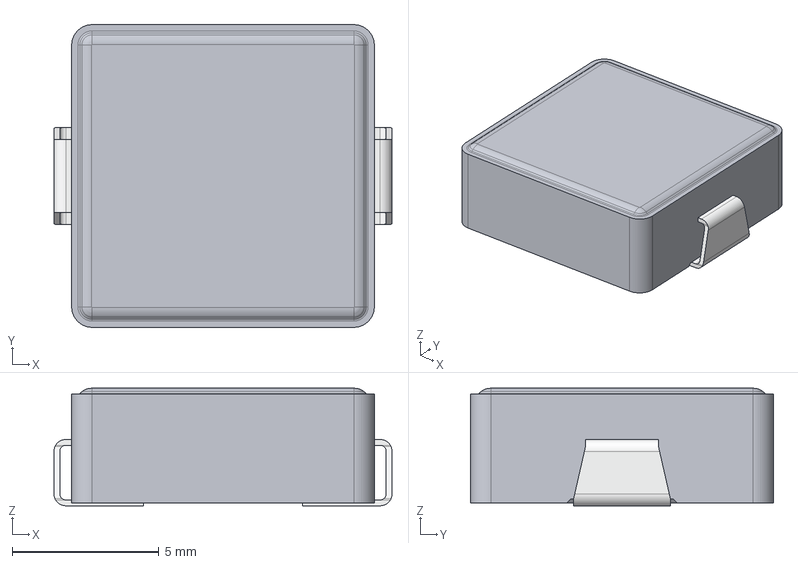
[picture p149: CAD file, 2017-12-06, last stored version]
Altium/3D models/Разные 3D модели/Inductors/SRP1038A-NLF.stp
11.5 x 10.3 x 4.00 mm
