Shitovdm/diploma/Altium/3D models/Разные 3D модели/rectangular/direct_wire/2.54mm/DS1018-206B.stp

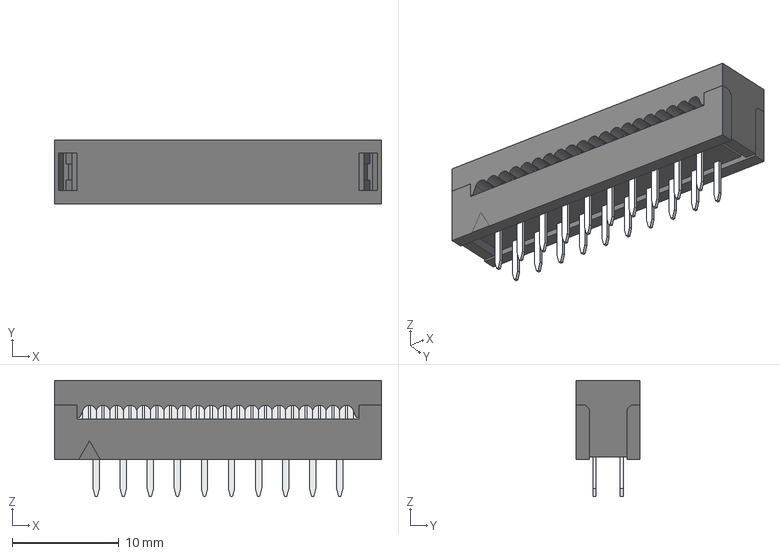
[picture p150: CAD file, 2017-12-06, last stored version]
Altium/3D models/Разные 3D модели/rectangular/direct_wire/2.54mm/DS1018-206B.stp
30.7 x 6.03 x 10.9 mm
