Shitovdm/diploma/Altium/3D models/Разные 3D модели/rectangular/female/vertical/2.54mm/DS1023-1x6SF11.stp

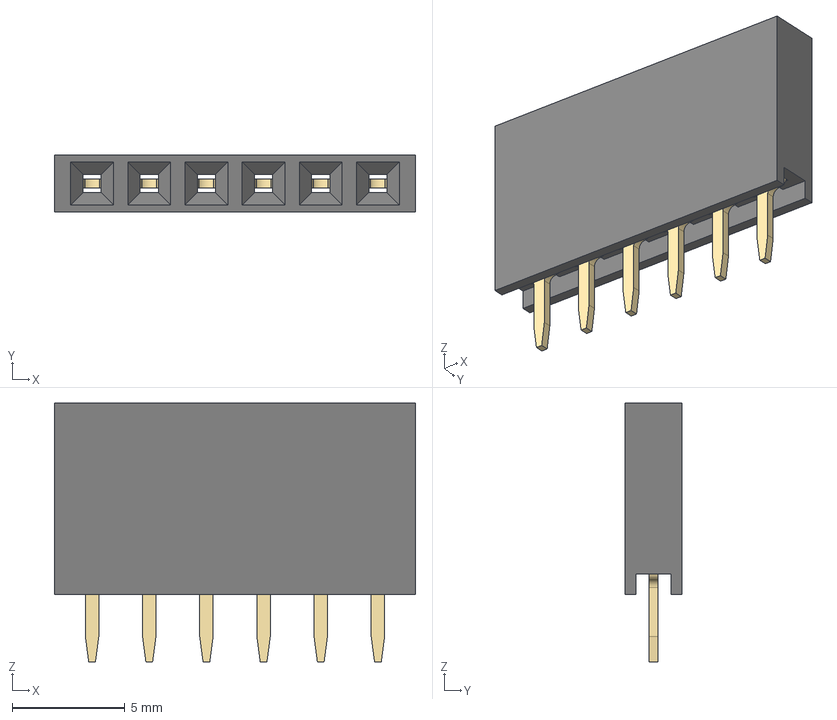
[picture p152: CAD file, 2017-12-06, last stored version]
Altium/3D models/Разные 3D модели/rectangular/female/vertical/2.54mm/DS1023-1x6SF11.stp
16.0 x 2.54 x 11.5 mm
