Shitovdm/diploma/Altium/3D models/Разные 3D модели/rectangular/female/vertical/2.54mm/Samtec/SDL-104-TT-12.stp

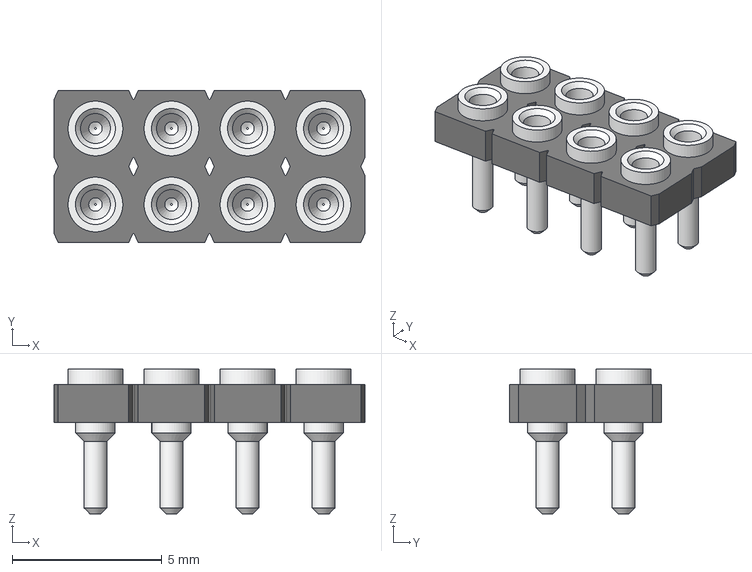
[picture p153: CAD file, 2017-12-06, last stored version]
Altium/3D models/Разные 3D модели/rectangular/female/vertical/2.54mm/Samtec/SDL-104-TT-12.stp
10.4 x 5.08 x 4.83 mm
