Shitovdm/diploma/Altium/3D models/Разные 3D модели/rectangular/male/shrouded/vertical/2.54mm/DS1013-40SSiB.stp

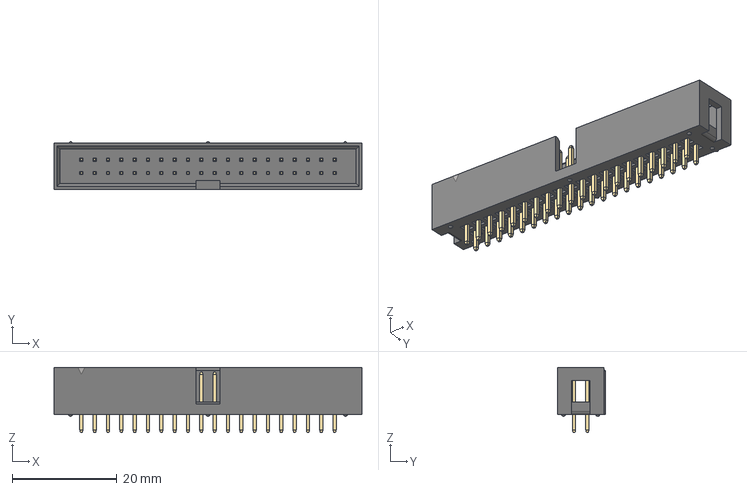
[picture p156: CAD file, 2017-12-06, last stored version]
Altium/3D models/Разные 3D модели/rectangular/male/shrouded/vertical/2.54mm/DS1013-40SSiB.stp
58.7 x 9.10 x 12.4 mm
