Shitovdm/diploma/Altium/3D models/Разные 3D модели/rectangular/male/unshrouded/right_angle/2.54mm/DS1070-5MRV6A.stp

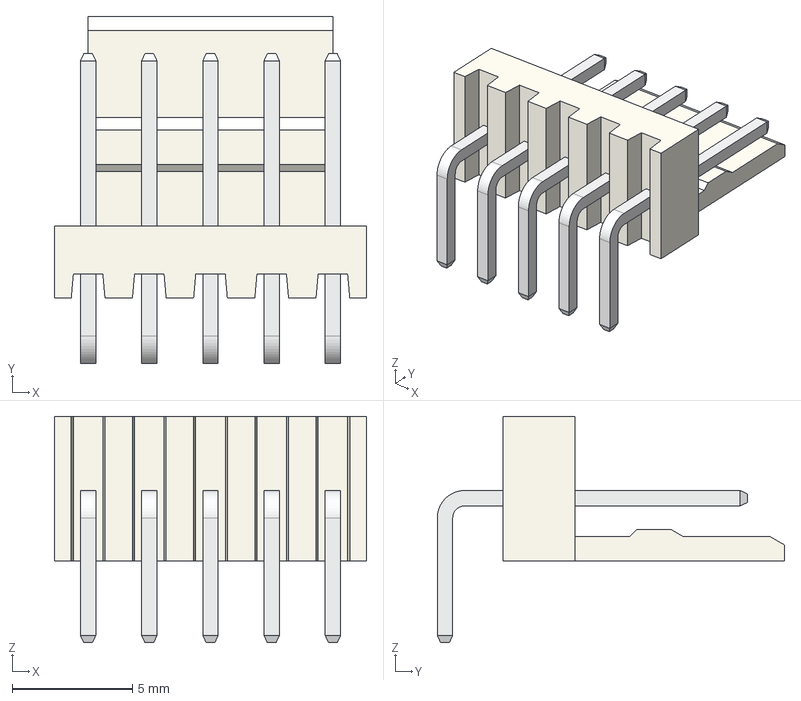
[picture p158: CAD file, 2017-12-06, last stored version]
Altium/3D models/Разные 3D модели/rectangular/male/unshrouded/right_angle/2.54mm/DS1070-5MRV6A.stp
12.9 x 14.4 x 9.40 mm
