Shitovdm/diploma/Altium/3D models/Разные 3D модели/Resistors/NTC-0805-T1.3.stp

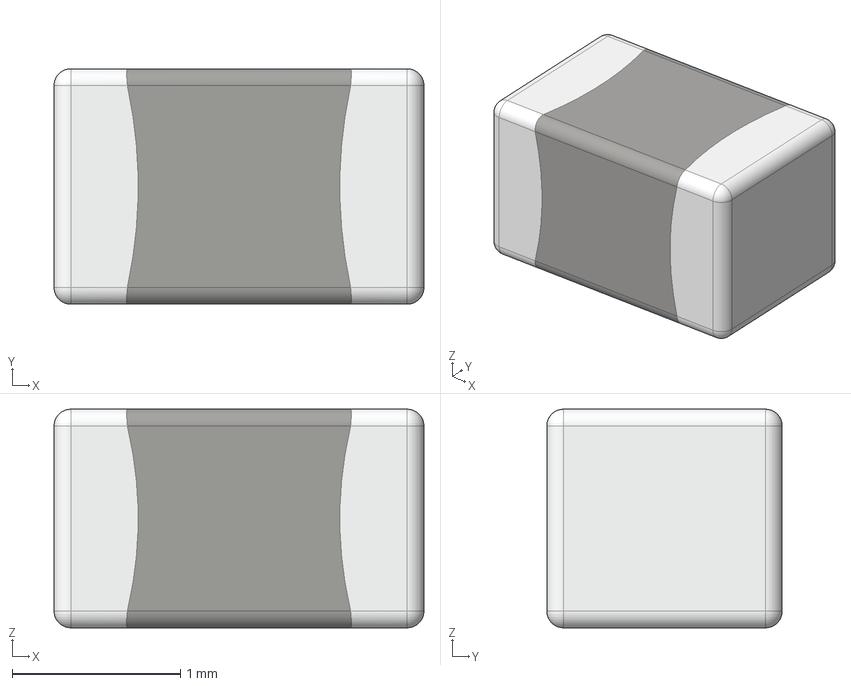
[picture p161: CAD file, 2017-12-06, last stored version]
Altium/3D models/Разные 3D модели/Resistors/NTC-0805-T1.3.stp
2.20 x 1.40 x 1.30 mm
