Shitovdm/diploma/Altium/3D models/Разные 3D модели/Capacitors/CAPC-1210-T2.7-BN.stp

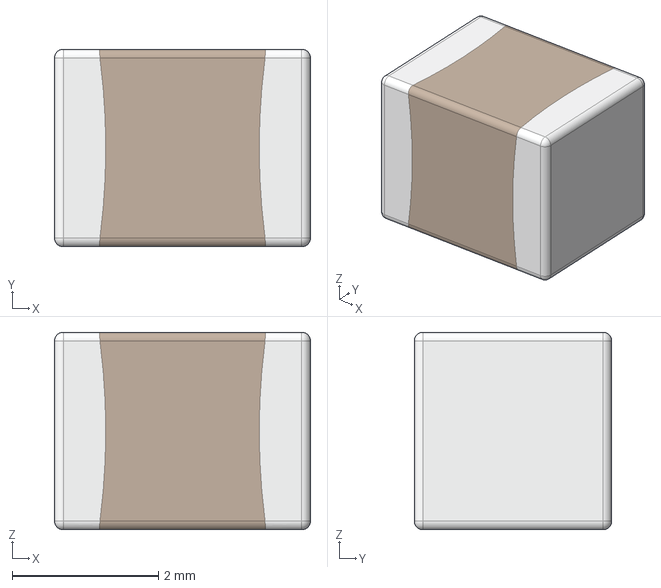
[picture p163: CAD file, 2017-12-06, last stored version]
Altium/3D models/Разные 3D модели/Capacitors/CAPC-1210-T2.7-BN.stp
3.50 x 2.70 x 2.70 mm
