Shitovdm/diploma/Altium/3D models/Разные 3D модели/DIP_sockets/DIP300-skt-flat-16.stp

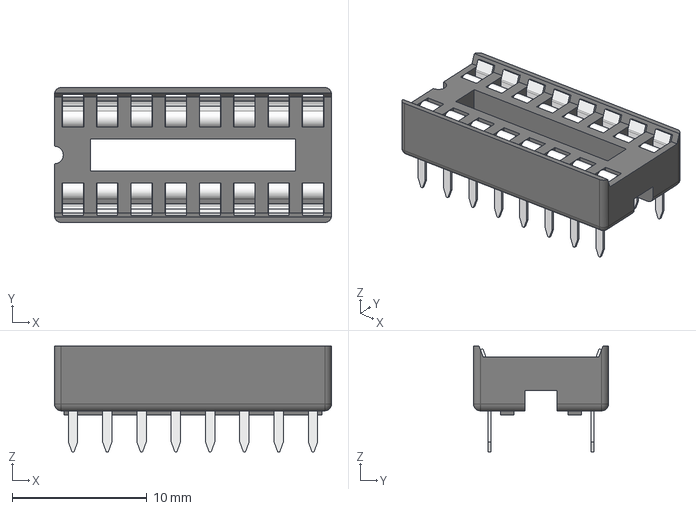
[picture p164: CAD file, 2017-12-06, last stored version]
Altium/3D models/Разные 3D модели/DIP_sockets/DIP300-skt-flat-16.stp
20.5 x 10.0 x 7.85 mm
