Shitovdm/diploma/Altium/3D models/Разные 3D модели/discrete-smd-1.snapshot.88/SC-76A.stp

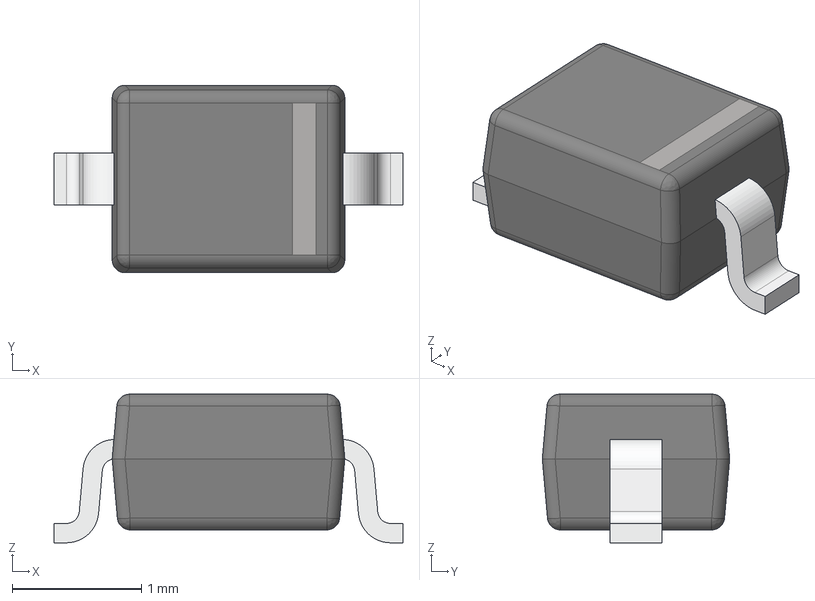
[picture p165: CAD file, 2017-12-06, last stored version]
Altium/3D models/Разные 3D модели/discrete-smd-1.snapshot.88/SC-76A.stp
2.70 x 1.45 x 1.15 mm
