Shitovdm/diploma/Altium/3D models/Разные 3D модели/rectangular/direct_wire/2.54mm/DS1018-166B.stp

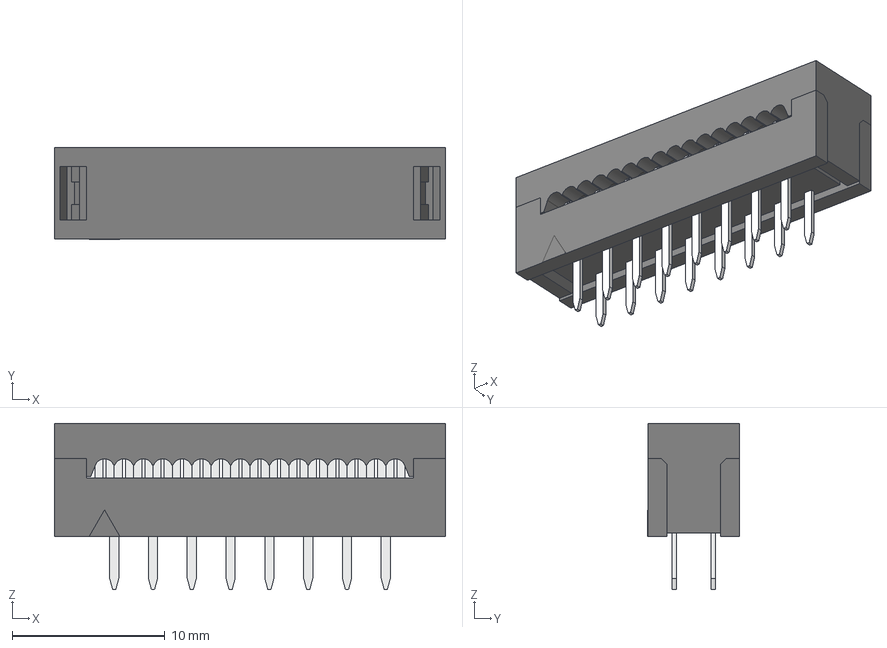
[picture p166: CAD file, 2017-12-06, last stored version]
Altium/3D models/Разные 3D модели/rectangular/direct_wire/2.54mm/DS1018-166B.stp
25.6 x 6.03 x 10.9 mm
