Shitovdm/diploma/Altium/3D models/Разные 3D модели/rectangular/female/right_angle/2.54mm/DS1024-2x3RF1.stp

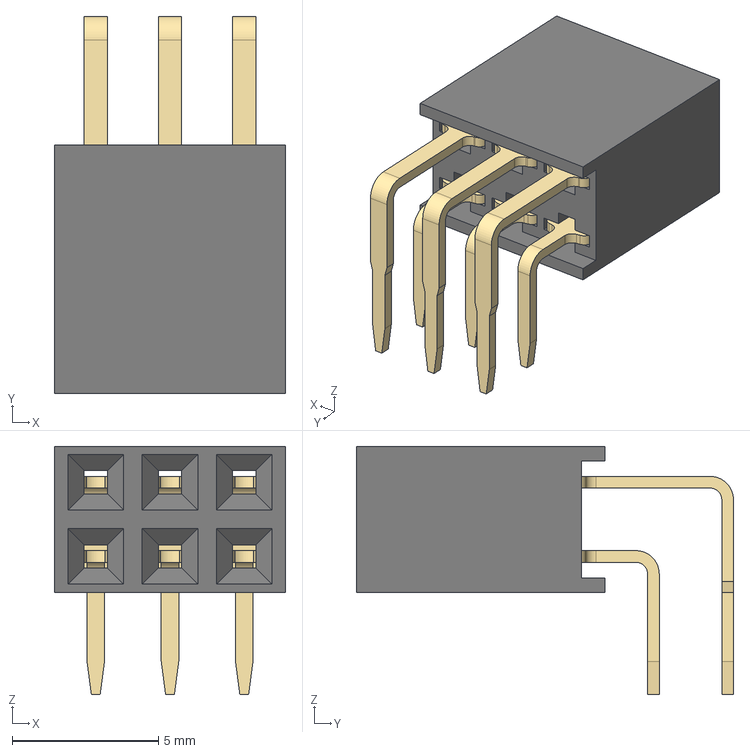
[picture p167: CAD file, 2017-12-06, last stored version]
Altium/3D models/Разные 3D модели/rectangular/female/right_angle/2.54mm/DS1024-2x3RF1.stp
7.92 x 12.9 x 8.50 mm
