Shitovdm/diploma/Altium/3D models/Разные 3D модели/rectangular/female/vertical/2.54mm/DS1023-1x5SF11.stp

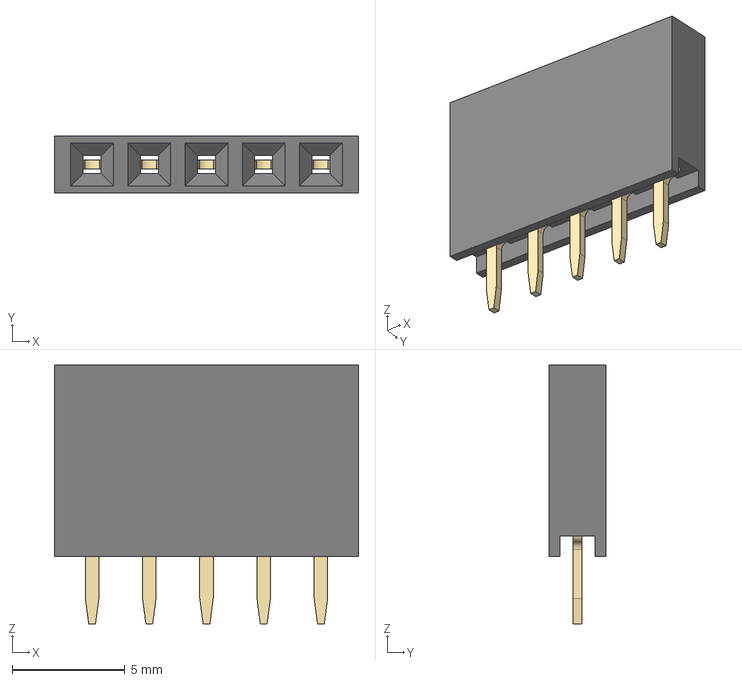
[picture p168: CAD file, 2017-12-06, last stored version]
Altium/3D models/Разные 3D модели/rectangular/female/vertical/2.54mm/DS1023-1x5SF11.stp
13.5 x 2.54 x 11.5 mm
