Shitovdm/diploma/Altium/3D models/Разные 3D модели/rectangular/male/shrouded/vertical/2.54mm/DS1013-20SSiB.stp

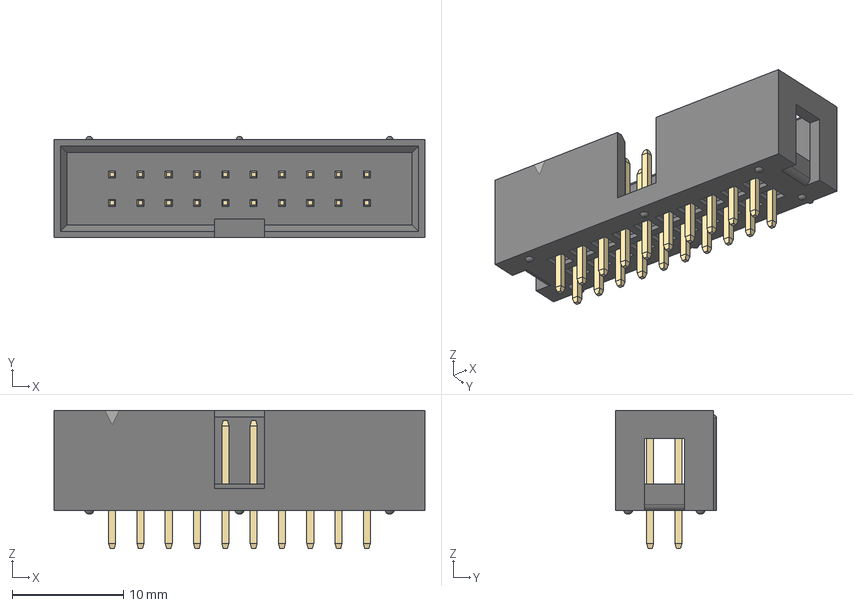
[picture p172: CAD file, 2017-12-06, last stored version]
Altium/3D models/Разные 3D модели/rectangular/male/shrouded/vertical/2.54mm/DS1013-20SSiB.stp
33.3 x 9.10 x 12.4 mm
