Shitovdm/diploma/Altium/3D models/Разные 3D модели/rectangular/male/shrouded/vertical/2.5mm/DS1069-5MVW6X.stp

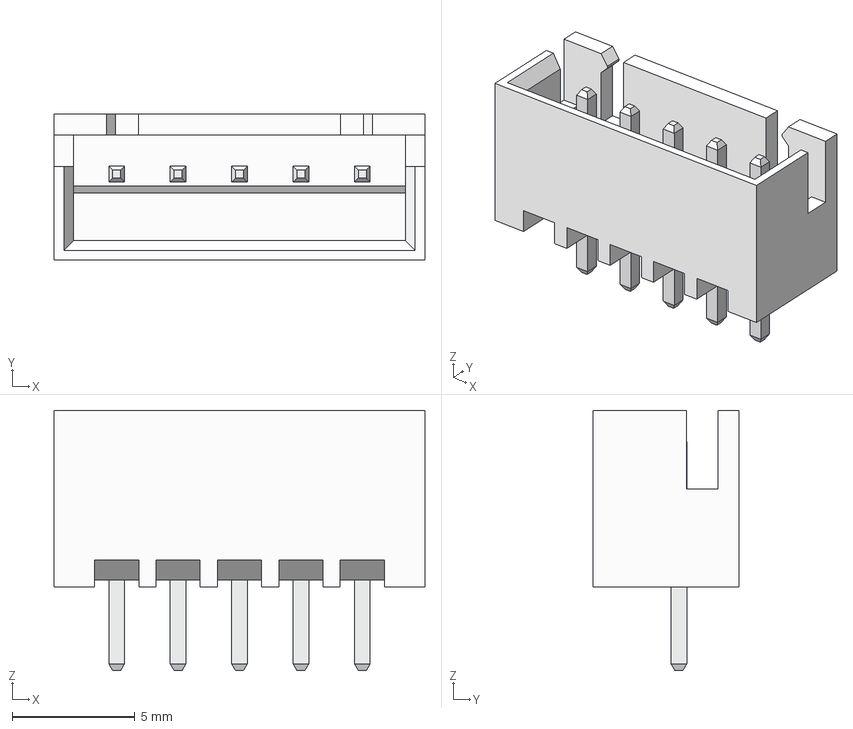
[picture p173: CAD file, 2017-12-06, last stored version]
Altium/3D models/Разные 3D модели/rectangular/male/shrouded/vertical/2.5mm/DS1069-5MVW6X.stp
15.1 x 5.95 x 10.6 mm
