Shitovdm/diploma/Altium/3D models/Разные 3D модели/Resistors/RESC-1218.stp

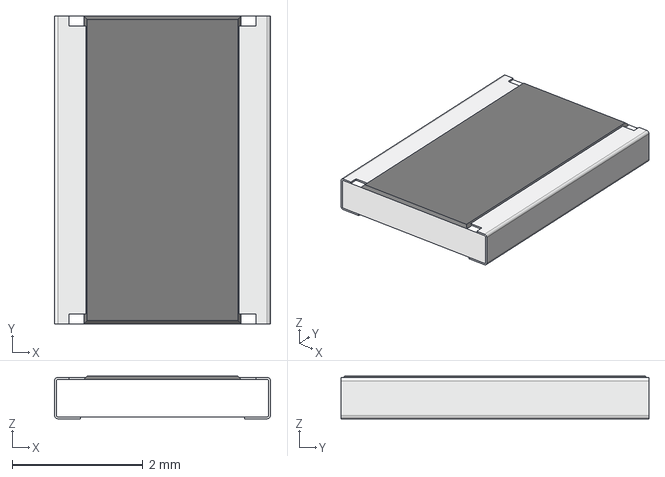
[picture p177: CAD file, 2017-12-06, last stored version]
Altium/3D models/Разные 3D модели/Resistors/RESC-1218.stp
3.30 x 4.70 x 0.65 mm
