Shitovdm/diploma/Altium/3D models/DS1022-1x2RD61.stp

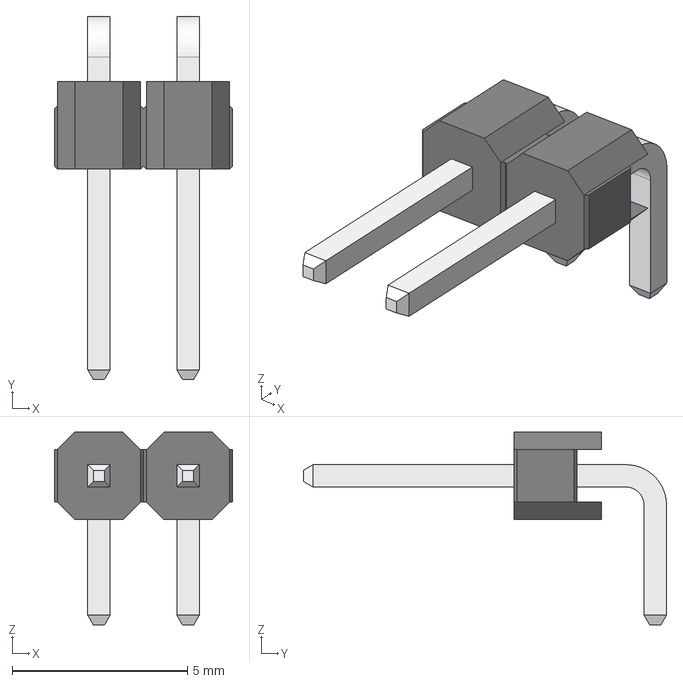
[picture p178: CAD file, 2017-12-06, last stored version]
Altium/3D models/DS1022-1x2RD61.stp
5.08 x 10.4 x 5.50 mm
