Shitovdm/diploma/Altium/3D models/Разные 3D модели/discrete-smd-1.snapshot.88/TO-236AB.stp

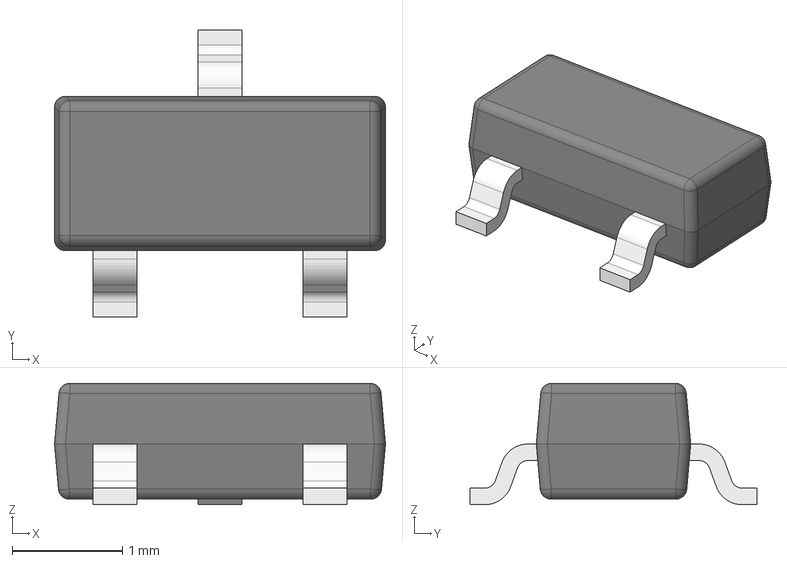
[picture p181: CAD file, 2017-12-06, last stored version]
Altium/3D models/Разные 3D модели/discrete-smd-1.snapshot.88/TO-236AB.stp
3.00 x 2.60 x 1.10 mm
