Shitovdm/diploma/Altium/3D models/Разные 3D модели/rectangular/female/vertical/2.54mm/DS1023-1x9SF11.stp

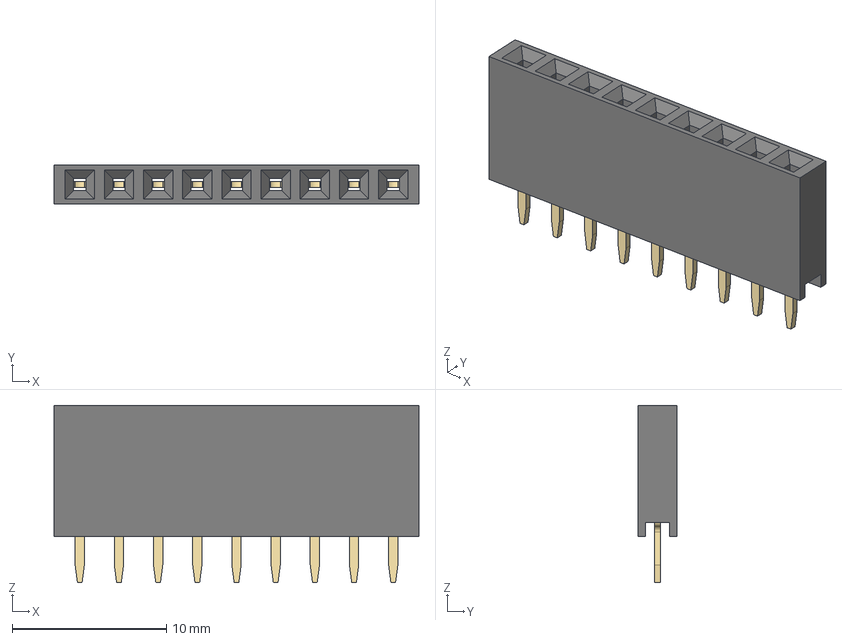
[picture p183: CAD file, 2017-12-06, last stored version]
Altium/3D models/Разные 3D модели/rectangular/female/vertical/2.54mm/DS1023-1x9SF11.stp
23.7 x 2.54 x 11.5 mm
