Shitovdm/diploma/Altium/3D models/Разные 3D модели/rectangular/female/vertical/2.54mm/Samtec/SL-102-TT-12.stp

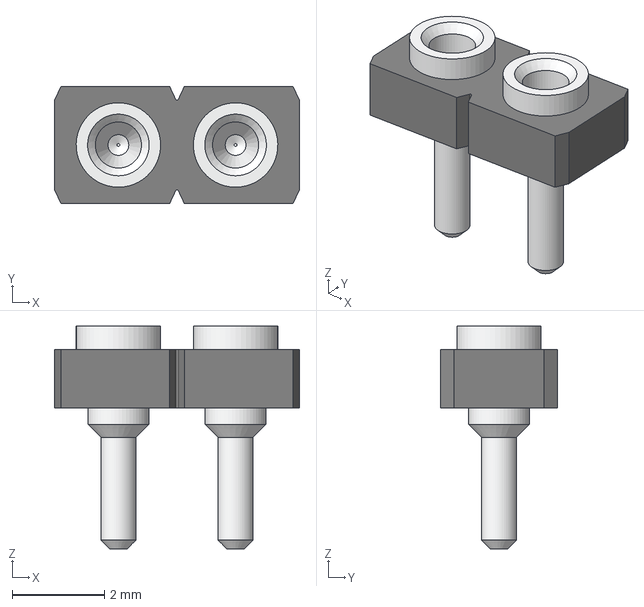
[picture p184: CAD file, 2017-12-06, last stored version]
Altium/3D models/Разные 3D модели/rectangular/female/vertical/2.54mm/Samtec/SL-102-TT-12.stp
5.31 x 2.54 x 4.83 mm
