Shitovdm/diploma/Altium/3D models/Разные 3D модели/rectangular/male/shrouded/vertical/2.54mm/DS1013-08SSiB.stp

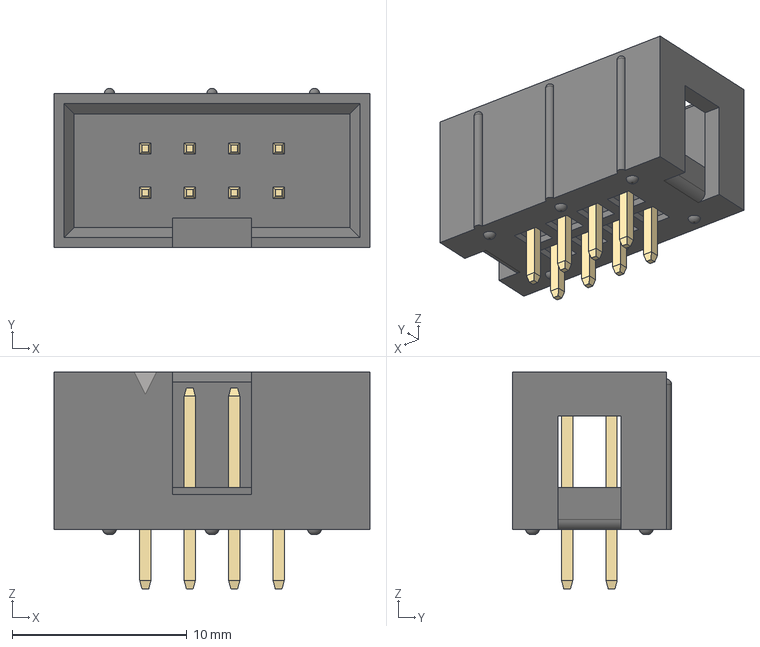
[picture p186: CAD file, 2017-12-06, last stored version]
Altium/3D models/Разные 3D модели/rectangular/male/shrouded/vertical/2.54mm/DS1013-08SSiB.stp
18.1 x 9.10 x 12.4 mm
