Shitovdm/diploma/Altium/3D models/Разные 3D модели/rectangular/male/unshrouded/right_angle/2.54mm/DS1022-1x7RD61.stp

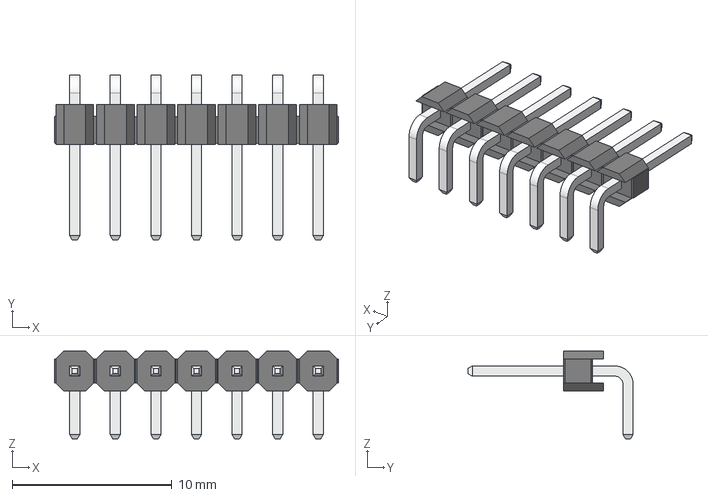
[picture p187: CAD file, 2017-12-06, last stored version]
Altium/3D models/Разные 3D модели/rectangular/male/unshrouded/right_angle/2.54mm/DS1022-1x7RD61.stp
17.8 x 10.4 x 5.50 mm
