Shitovdm/diploma/Altium/3D models/Разные 3D модели/rectangular/male/unshrouded/vertical/2.54mm/DS1021-1x6S61.stp

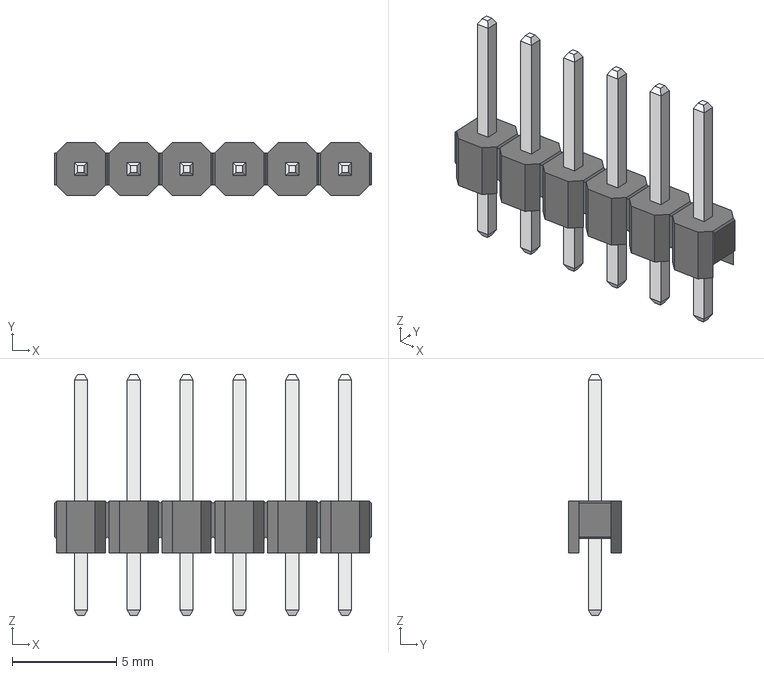
[picture p189: CAD file, 2017-12-06, last stored version]
Altium/3D models/Разные 3D модели/rectangular/male/unshrouded/vertical/2.54mm/DS1021-1x6S61.stp
15.2 x 2.54 x 11.6 mm
