Shitovdm/diploma/Altium/3D models/Разные 3D модели/Resistors/CAT16-x4.stp

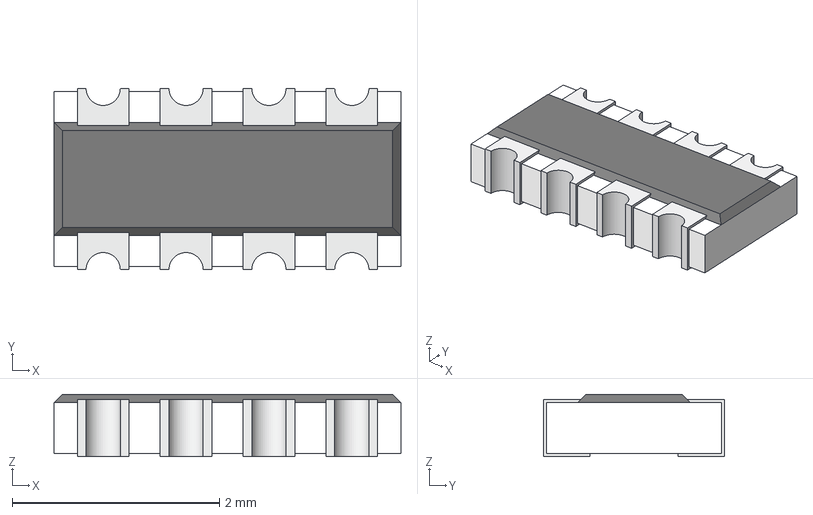
[picture p190: CAD file, 2017-12-06, last stored version]
Altium/3D models/Разные 3D модели/Resistors/CAT16-x4.stp
3.35 x 1.75 x 0.6 mm
