Shitovdm/diploma/Altium/3D models/3528 SMD LED.stp

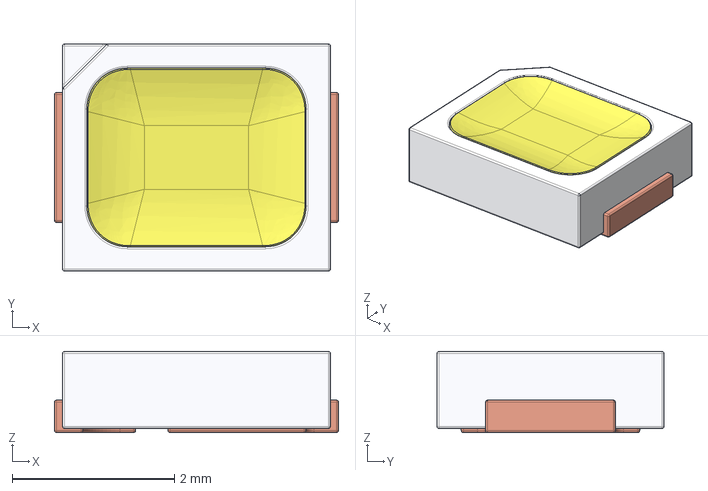
[picture p191: CAD file, 2017-12-06, last stored version]
Altium/3D models/3528 SMD LED.stp
3.50 x 2.80 x 1.00 mm
