Shitovdm/diploma/Altium/3D models/Разные 3D модели/Capacitors/CAPAE-D5.0x5.4.stp

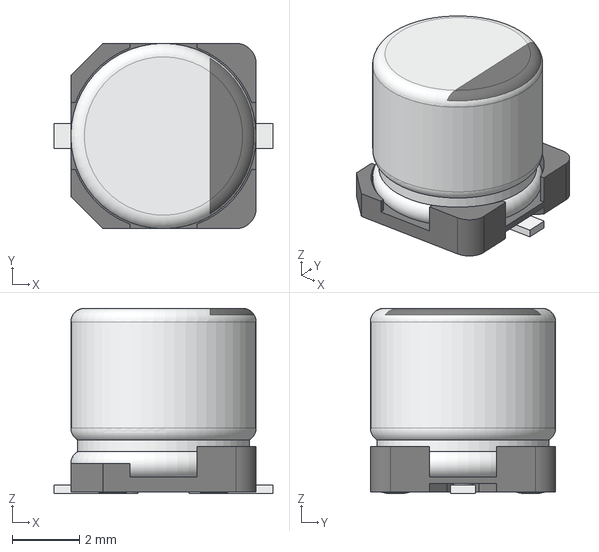
[picture p192: CAD file, 2017-12-06, last stored version]
Altium/3D models/Разные 3D модели/Capacitors/CAPAE-D5.0x5.4.stp
6.50 x 5.50 x 5.50 mm
