Shitovdm/diploma/Altium/3D models/Разные 3D модели/rectangular/female/vertical/2.54mm/Samtec/SL-109-TT-12.stp

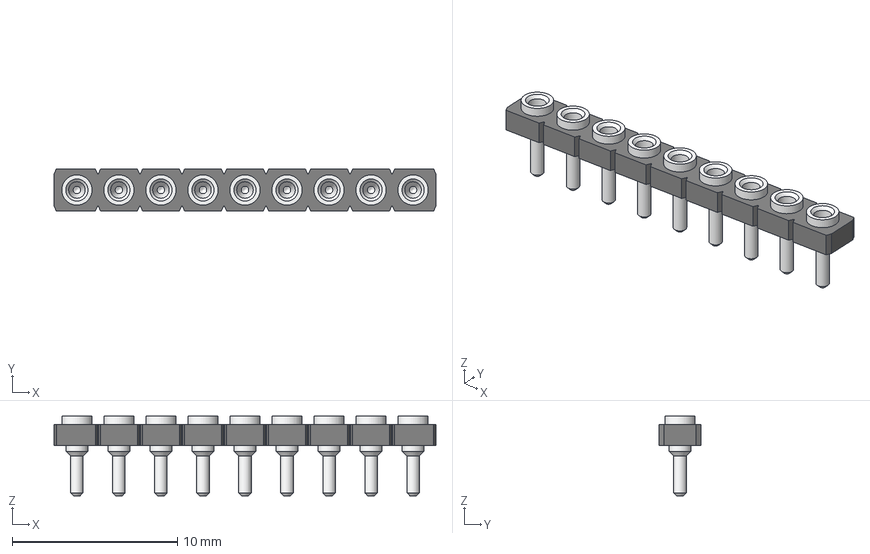
[picture p197: CAD file, 2017-12-06, last stored version]
Altium/3D models/Разные 3D модели/rectangular/female/vertical/2.54mm/Samtec/SL-109-TT-12.stp
23.1 x 2.54 x 4.83 mm
