Shitovdm/diploma/Altium/3D models/Разные 3D модели/Resistors/RESC-2010.stp

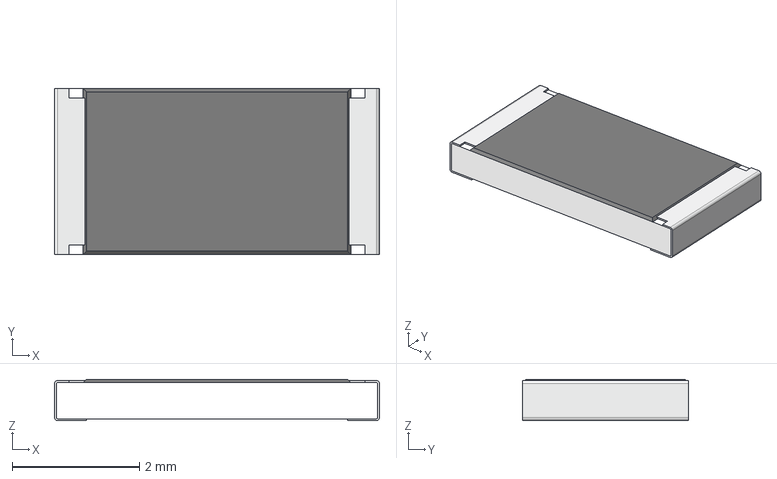
[picture p203: CAD file, 2017-12-06, last stored version]
Altium/3D models/Разные 3D модели/Resistors/RESC-2010.stp
5.10 x 2.60 x 0.65 mm
