Shitovdm/diploma/Altium/3D models/TQFP-32.STEP

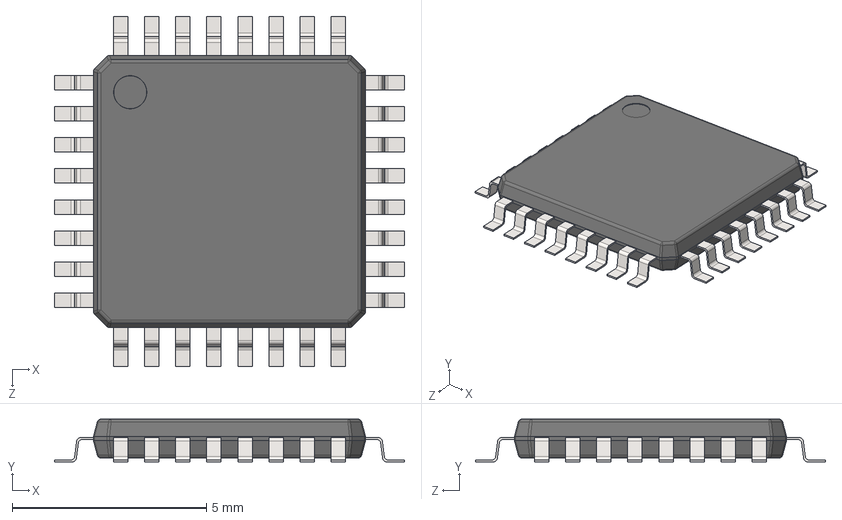
[picture p204: CAD file, 2017-12-06, last stored version]
Altium/3D models/TQFP-32.STEP
9.00 x 1.10 x 9.00 mm
