Shitovdm/diploma/Altium/3D models/Разные 3D модели/Capacitors/CAPC-1210-T1.8-BN.stp

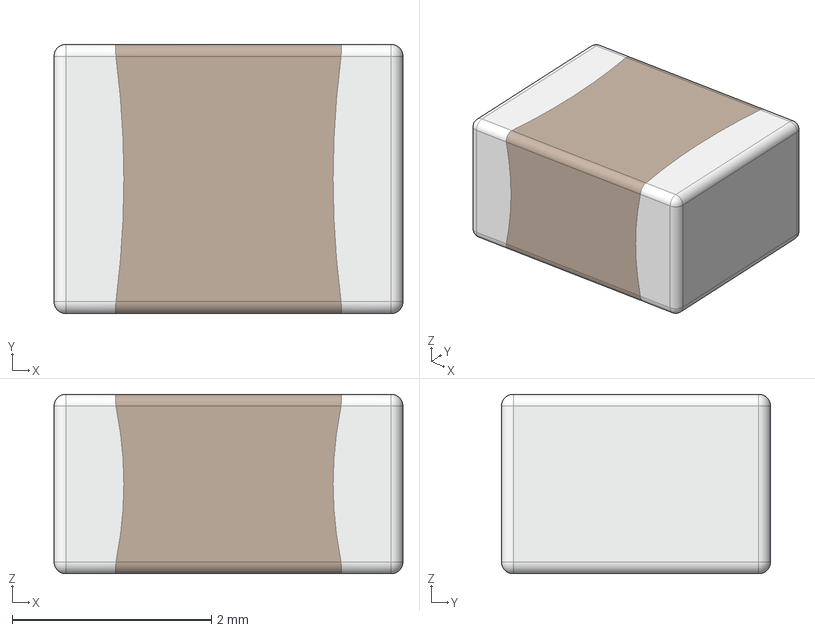
[picture p205: CAD file, 2017-12-06, last stored version]
Altium/3D models/Разные 3D модели/Capacitors/CAPC-1210-T1.8-BN.stp
3.50 x 2.70 x 1.80 mm
