Shitovdm/diploma/Altium/3D models/Разные 3D модели/discrete-smd-1.snapshot.88/DO-215AD.stp

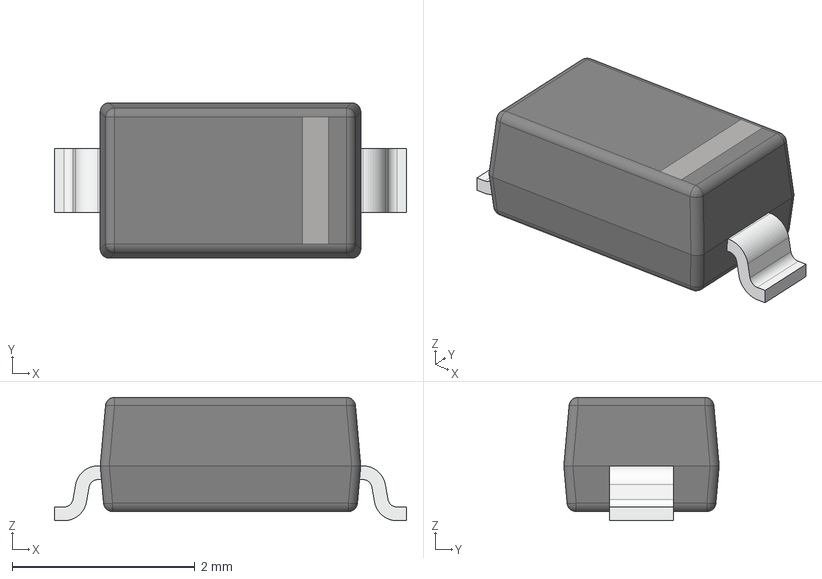
[picture p207: CAD file, 2017-12-06, last stored version]
Altium/3D models/Разные 3D модели/discrete-smd-1.snapshot.88/DO-215AD.stp
3.85 x 1.70 x 1.35 mm
