Shitovdm/diploma/Altium/3D models/Разные 3D модели/Resistors/NTC-1206-T1.3.stp

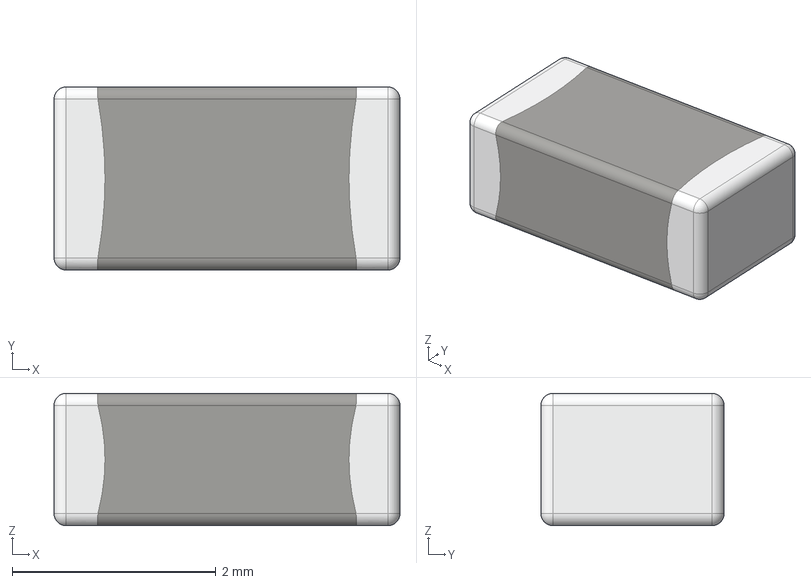
[picture p214: CAD file, 2017-12-06, last stored version]
Altium/3D models/Разные 3D модели/Resistors/NTC-1206-T1.3.stp
3.40 x 1.80 x 1.30 mm
