Shitovdm/diploma/Altium/3D models/Разные 3D модели/Capacitors/CAPAE-D4.0x5.4.stp

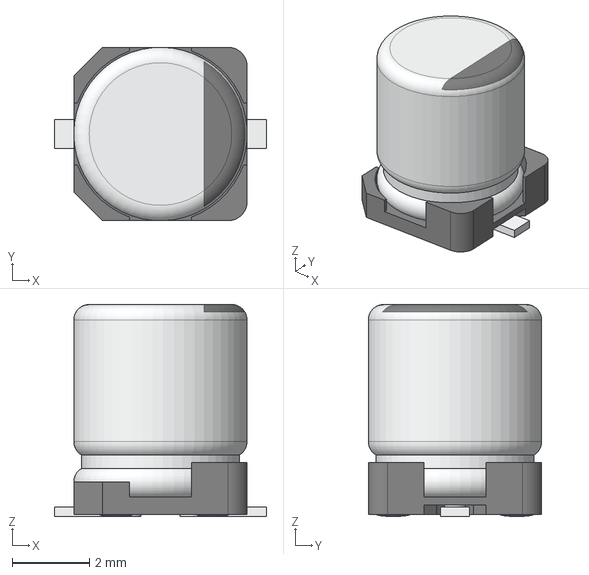
[picture p216: CAD file, 2017-12-06, last stored version]
Altium/3D models/Разные 3D модели/Capacitors/CAPAE-D4.0x5.4.stp
5.50 x 4.50 x 5.50 mm
