Shitovdm/diploma/Altium/3D models/Разные 3D модели/discrete-smd-1.snapshot.88/DO-221BA.stp

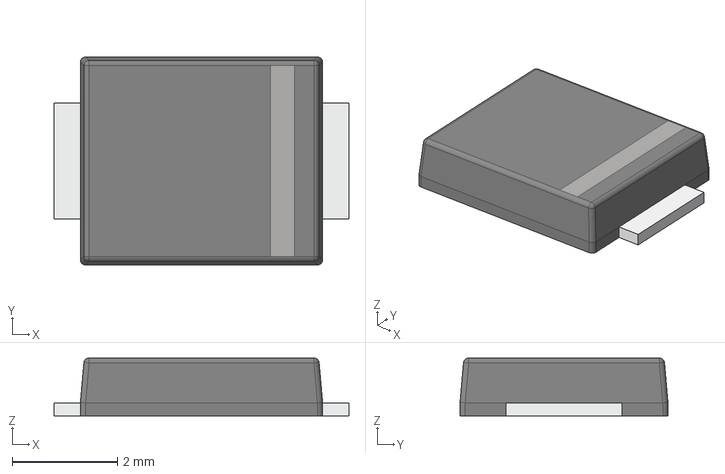
[picture p218: CAD file, 2017-12-06, last stored version]
Altium/3D models/Разные 3D модели/discrete-smd-1.snapshot.88/DO-221BA.stp
5.60 x 3.95 x 1.10 mm
