Shitovdm/diploma/Altium/3D models/Разные 3D модели/rectangular/female/vertical/2.54mm/Samtec/SDL-101-TT-10.stp

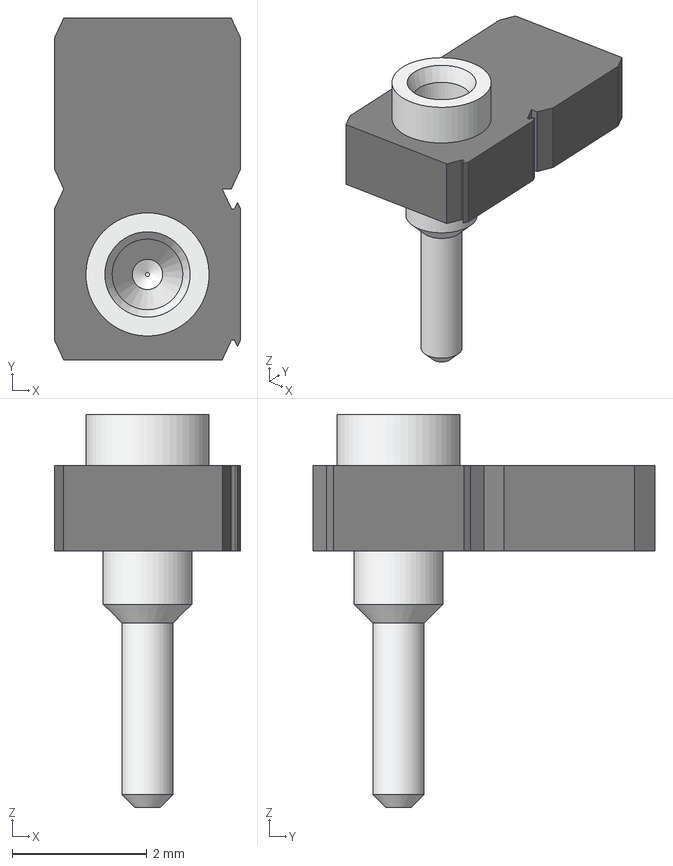
[picture p221: CAD file, 2017-12-06, last stored version]
Altium/3D models/Разные 3D модели/rectangular/female/vertical/2.54mm/Samtec/SDL-101-TT-10.stp
2.77 x 5.08 x 5.84 mm
