Shitovdm/diploma/Altium/3D models/Разные 3D модели/Resistors/RESMELF-0102.stp

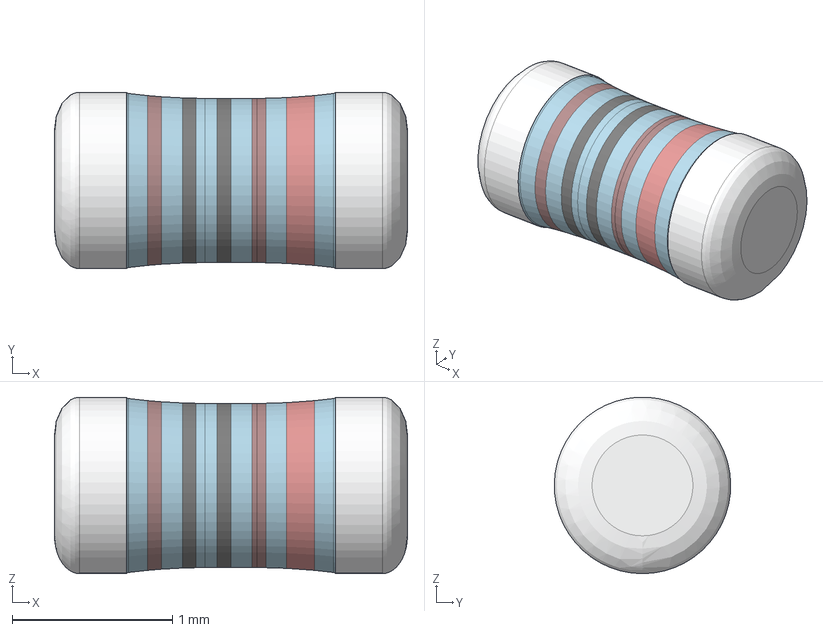
[picture p225: CAD file, 2017-12-06, last stored version]
Altium/3D models/Разные 3D модели/Resistors/RESMELF-0102.stp
2.20 x 1.10 x 1.10 mm
