Shitovdm/diploma/Altium/3D models/Разные 3D модели/Capacitors/CAPAE-D8.0x10.2.stp

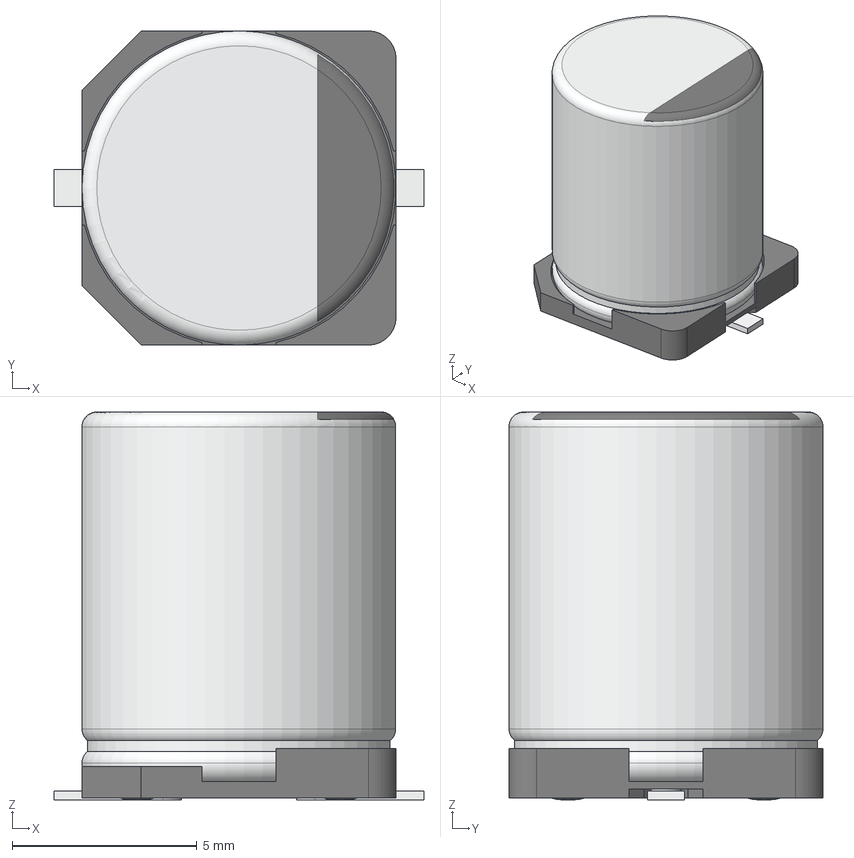
[picture p226: CAD file, 2017-12-06, last stored version]
Altium/3D models/Разные 3D модели/Capacitors/CAPAE-D8.0x10.2.stp
10.0 x 8.50 x 10.5 mm
