Shitovdm/diploma/Altium/3D models/TO-253AA.stp

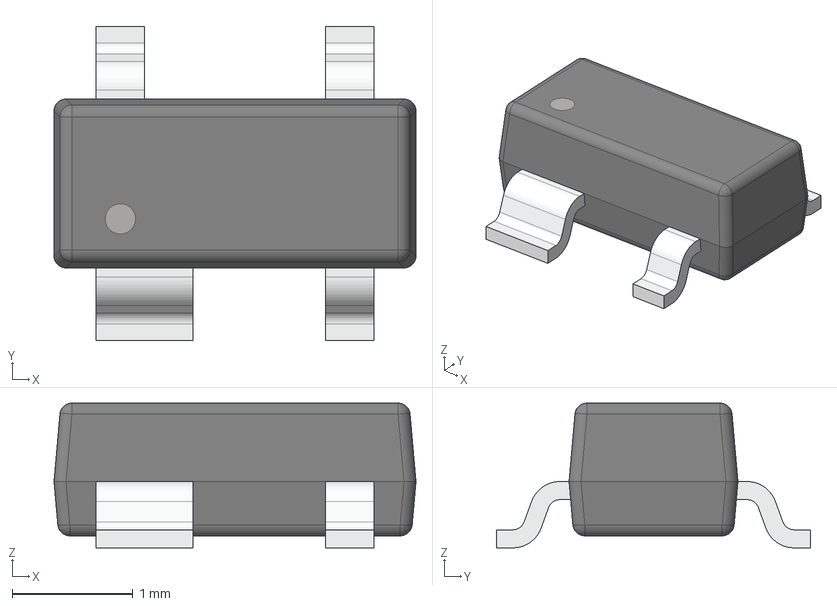
[picture p234: CAD file, 2017-12-06, last stored version]
Altium/3D models/TO-253AA.stp
3.00 x 2.60 x 1.20 mm
