Shitovdm/diploma/Altium/3D models/Разные 3D модели/Capacitors/CAPM-TANTA-YL.stp

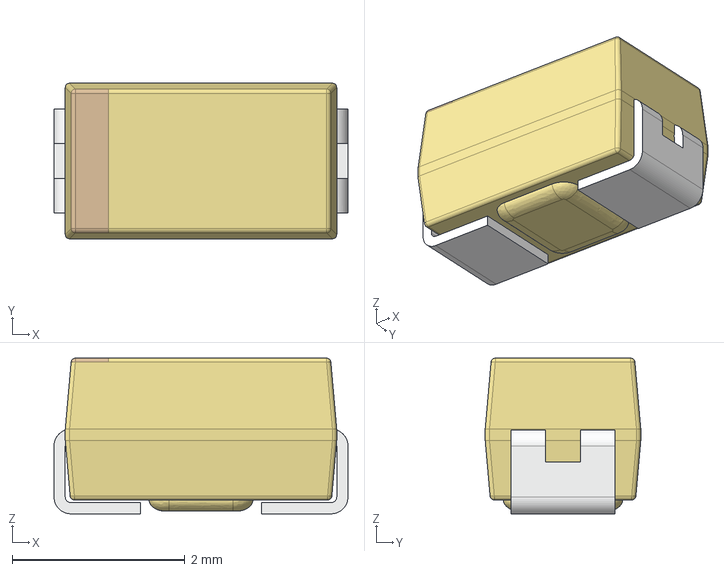
[picture p235: CAD file, 2017-12-06, last stored version]
Altium/3D models/Разные 3D модели/Capacitors/CAPM-TANTA-YL.stp
3.40 x 1.80 x 1.80 mm
