Shitovdm/diploma/Altium/3D models/Разные 3D модели/discrete-smd-1.snapshot.88/DO-213AA-RED.stp

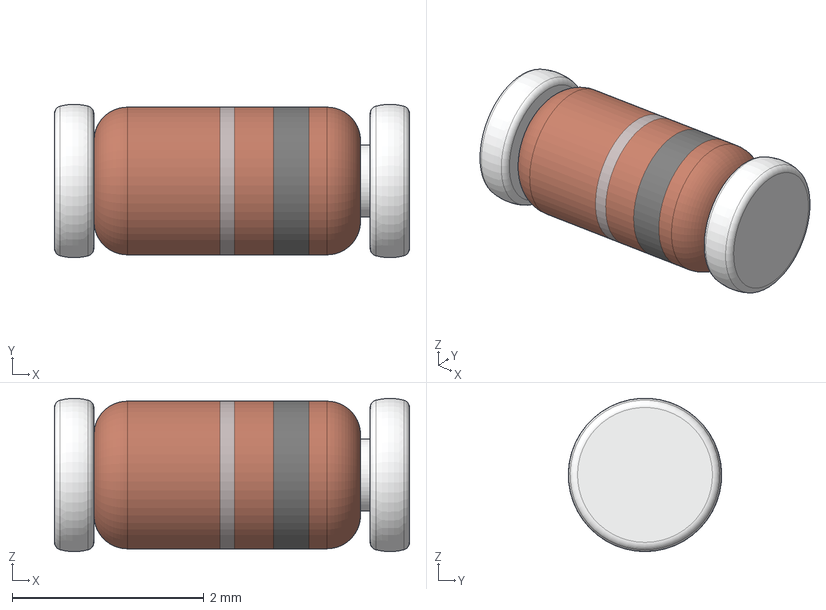
[picture p236: CAD file, 2017-12-06, last stored version]
Altium/3D models/Разные 3D модели/discrete-smd-1.snapshot.88/DO-213AA-RED.stp
3.70 x 1.60 x 1.60 mm
