Shitovdm/diploma/Altium/3D models/Разные 3D модели/rectangular/female/vertical/2.54mm/Samtec/SDL-110-TT-11.stp

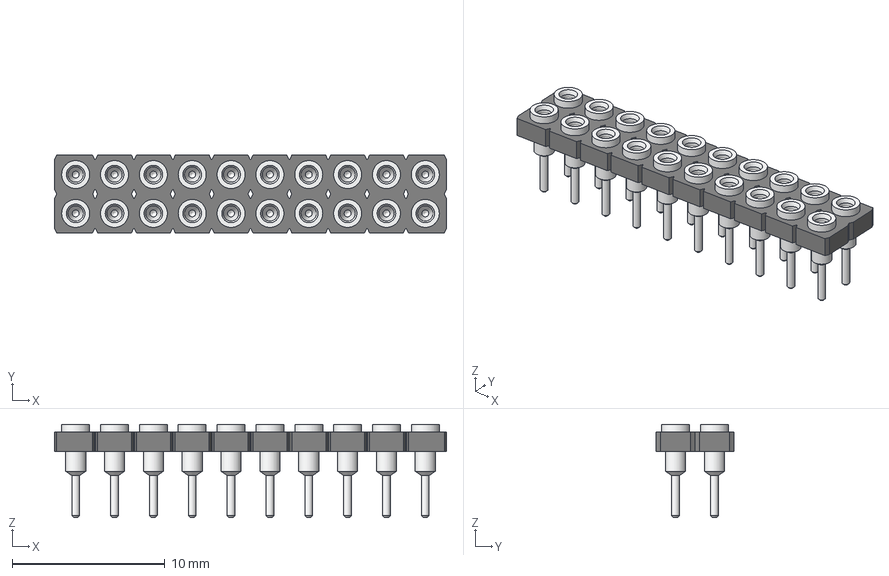
[picture p239: CAD file, 2017-12-06, last stored version]
Altium/3D models/Разные 3D модели/rectangular/female/vertical/2.54mm/Samtec/SDL-110-TT-11.stp
25.6 x 5.08 x 6.10 mm
