Shitovdm/diploma/(list of files, cad)

Other CAD files:
Altium/diploma/Complete/dwg/Структурная схема.dwg
Altium/diploma/Complete/SB.dwg
Altium/diploma/Project Outputs for diploma/AutoCAD PCB/PCB2.DWG
Altium/diploma/tacad102/SPDS_A2v1.dwg
Altium/export/Scheme.dwg
Technological part/ALGO.dwg
Altium/diploma/tacad102/ESKD_A4v2.dwg
Altium/diploma/tacad102/ESKD_A2v2.dwg
Altium/diploma/tacad102/SPDS_A3h2.dwg
Altium/diploma/tacad102/ESKD_A4v1.dwg
Altium/diploma/tacad102/ESKD_A3h1.dwg
Altium/diploma/tacad102/SPDS_A3v2.dwg
Altium/diploma/tacad102/SPDS_A2h1.dwg
Altium/3D models/DS1021-1x2S61.stp
Altium/3D models/Разные 3D модели/rectangular/male/unshrouded/vertical/2.54mm/DS1021-1x4SF11.stp
Altium/diploma/tacad102/ESKD_A2v1.dwg
Altium/3D models/Разные 3D модели/Capacitors/CAPAE-D6.3x5.4.stp
Altium/3D models/Разные 3D модели/Capacitors/CAPC-0402-T0.55-BN.stp
Altium/3D models/Разные 3D модели/Capacitors/CAPC-0603-T0.9-BN.stp
Altium/3D models/Разные 3D модели/Capacitors/CAPC-0805-T0.75-BN.stp
Altium/3D models/Разные 3D модели/Capacitors/CAPC-0805-T0.95-BN.stp
Altium/3D models/Разные 3D модели/Capacitors/CAPC-0805-T1.35-BN.stp
Altium/3D models/Разные 3D модели/Capacitors/CAPC-1206-T1.0-BN.stp
Altium/3D models/Разные 3D модели/Capacitors/CAPC-1206-T1.4-BN.stp
Altium/3D models/Разные 3D модели/Capacitors/CAPC-1206-T1.8-BN.stp
Altium/3D models/Разные 3D модели/Capacitors/CAPC-1210-T1.45-BN.stp
Altium/3D models/Разные 3D модели/Capacitors/CAPM-TANTA-BK.stp
Altium/3D models/Разные 3D модели/Capacitors/CAPM-TANTB-BK.stp
Altium/3D models/Разные 3D модели/Capacitors/CAPM-TANTC-BK.stp
Altium/3D models/Разные 3D модели/Capacitors/CAPM-TANTC-YL.stp
Altium/3D models/Разные 3D модели/Capacitors/CAPM-TANTD-YL.stp
Altium/3D models/Разные 3D модели/Capacitors/CAPM-TANTN-BK.stp
Altium/3D models/Разные 3D модели/Resistors/3224X.stp
Altium/3D models/Разные 3D модели/Resistors/CAT16-x8.stp
Altium/3D models/Разные 3D модели/Resistors/CAY16-J2.stp
Altium/3D models/Разные 3D модели/Resistors/CAY16-J8.stp
Altium/3D models/Разные 3D модели/Resistors/NTC-0402-T0.6.stp
Altium/3D models/Разные 3D модели/Resistors/NTC-0603-T0.9.stp
Altium/3D models/Разные 3D модели/Resistors/RESC-0402.stp
Altium/3D models/Разные 3D модели/Resistors/RESC-0603.stp
Altium/3D models/Разные 3D модели/Resistors/RESC-0805.stp
Altium/3D models/Разные 3D модели/Resistors/RESC-1206.stp
Altium/3D models/Разные 3D модели/Resistors/RESC-2512.stp
Altium/3D models/Разные 3D модели/Resistors/RESMELF-0204.stp
Altium/3D models/Разные 3D модели/Resistors/RESMELF-0207.stp
Altium/3D models/Разные 3D модели/discrete-smd-1.snapshot.88/DB-S.stp
Altium/3D models/Разные 3D модели/discrete-smd-1.snapshot.88/DO-213AB-RED.stp
Altium/3D models/Разные 3D модели/discrete-smd-1.snapshot.88/DO-213AB.stp
Altium/3D models/Разные 3D модели/discrete-smd-1.snapshot.88/DO-214AA.stp
Altium/3D models/Разные 3D модели/discrete-smd-1.snapshot.88/DO-214AC-DIOM5127X23N.stp
Altium/3D models/Разные 3D модели/discrete-smd-1.snapshot.88/DO-214AC.stp
Altium/3D models/Разные 3D модели/discrete-smd-1.snapshot.88/DO-219AB.stp
Altium/3D models/Разные 3D модели/discrete-smd-1.snapshot.88/DO-221AA.stp
Altium/3D models/Разные 3D модели/discrete-smd-1.snapshot.88/DO-221AB.stp
Altium/3D models/Разные 3D модели/discrete-smd-1.snapshot.88/DO-221AC.stp
Altium/3D models/Разные 3D модели/discrete-smd-1.snapshot.88/DO-221BB.stp
Altium/3D models/Разные 3D модели/discrete-smd-1.snapshot.88/DO-221BC.stp
Altium/3D models/Разные 3D модели/discrete-smd-1.snapshot.88/Fair_Micro-DIP.stp
Altium/3D models/Разные 3D модели/discrete-smd-1.snapshot.88/SC-59A.stp
Altium/3D models/Разные 3D модели/discrete-smd-1.snapshot.88/SC-70.stp
Altium/3D models/Разные 3D модели/discrete-smd-1.snapshot.88/SC-79.stp
Altium/3D models/Разные 3D модели/discrete-smd-1.snapshot.88/SOT89-5L.stp
Altium/3D models/Разные 3D модели/discrete-smd-1.snapshot.88/TO-243AA.stp
Altium/3D models/Разные 3D модели/discrete-smd-1.snapshot.88/TO-252AA-IRF.stp
Altium/3D models/Разные 3D модели/discrete-smd-1.snapshot.88/TO-252AA-Vishay.stp
Altium/3D models/Разные 3D модели/discrete-smd-1.snapshot.88/TO-261AA.stp
Altium/3D models/Разные 3D модели/discrete-smd-1.snapshot.88/TO-263AB.stp
Altium/3D models/Разные 3D модели/discrete-smd-1.snapshot.88/TO-263BA.stp
Altium/3D models/Разные 3D модели/discrete-smd-1.snapshot.88/TO-269AA.stp
Altium/3D models/Разные 3D модели/discrete-smd-1.snapshot.88/microMELF-RED.stp
Altium/3D models/Разные 3D модели/rectangular/female/right_angle/2.54mm/DS1024-1x10RF1.stp
Altium/3D models/Разные 3D модели/rectangular/female/right_angle/2.54mm/DS1024-1x2RF1.stp
Altium/3D models/Разные 3D модели/rectangular/female/right_angle/2.54mm/DS1024-1x6RF1.stp
Altium/3D models/Разные 3D модели/rectangular/female/right_angle/2.54mm/DS1024-1x7RF1.stp
Altium/3D models/Разные 3D модели/rectangular/female/right_angle/2.54mm/DS1024-1x9RF1.stp
Altium/3D models/Разные 3D модели/rectangular/female/right_angle/2.54mm/DS1024-2x10RF1.stp
Altium/3D models/Разные 3D модели/rectangular/female/right_angle/2.54mm/DS1024-2x2RF1.stp
Altium/3D models/Разные 3D модели/rectangular/female/right_angle/2.54mm/DS1024-2x4RF1.stp
Altium/3D models/Разные 3D модели/rectangular/female/right_angle/2.54mm/DS1024-2x5RF1.stp
Altium/3D models/Разные 3D модели/rectangular/female/right_angle/2.54mm/DS1024-2x6RF1.stp
Altium/3D models/Разные 3D модели/rectangular/female/vertical/2.54mm/DS1023-1x1SF11.stp
Altium/3D models/Разные 3D модели/rectangular/female/vertical/2.54mm/DS1023-1x2SF11.stp
Altium/3D models/Разные 3D модели/rectangular/female/vertical/2.54mm/DS1023-1x3SF11.stp
Altium/3D models/Разные 3D модели/rectangular/female/vertical/2.54mm/DS1023-1x4SF11.stp
Altium/3D models/Разные 3D модели/rectangular/female/vertical/2.54mm/DS1023-1x7SF11.stp
Altium/3D models/Разные 3D модели/rectangular/female/vertical/2.54mm/DS1023-2x2SF11.stp
Altium/3D models/Разные 3D модели/rectangular/female/vertical/2.54mm/DS1023-2x3SF11.stp
Altium/3D models/Разные 3D модели/rectangular/female/vertical/2.54mm/DS1023-2x4SF11.stp
Altium/3D models/Разные 3D модели/rectangular/female/vertical/2.54mm/DS1023-2x8SF11.stp
Altium/3D models/Разные 3D модели/rectangular/female/vertical/2.54mm/DS1023-2x9SF11.stp
Altium/3D models/Разные 3D модели/rectangular/female/vertical/2.54mm/Samtec/SDL-101-TT-11.stp
Altium/3D models/Разные 3D модели/rectangular/female/vertical/2.54mm/Samtec/SDL-101-TT-12.stp
Altium/3D models/Разные 3D модели/rectangular/female/vertical/2.54mm/Samtec/SDL-101-TT-19.stp
Altium/3D models/Разные 3D модели/rectangular/female/vertical/2.54mm/Samtec/SDL-102-TT-10.stp
Altium/3D models/Разные 3D модели/rectangular/female/vertical/2.54mm/Samtec/SDL-102-TT-11.stp
Altium/3D models/Разные 3D модели/rectangular/female/vertical/2.54mm/Samtec/SDL-102-TT-12.stp
Altium/3D models/Разные 3D модели/rectangular/female/vertical/2.54mm/Samtec/SDL-102-TT-19.stp
Altium/3D models/Разные 3D модели/rectangular/female/vertical/2.54mm/Samtec/SDL-103-TT-10.stp
Altium/3D models/Разные 3D модели/rectangular/female/vertical/2.54mm/Samtec/SDL-103-TT-11.stp
Altium/3D models/Разные 3D модели/rectangular/female/vertical/2.54mm/Samtec/SDL-103-TT-12.stp
Altium/3D models/Разные 3D модели/rectangular/female/vertical/2.54mm/Samtec/SDL-103-TT-19.stp
Altium/3D models/Разные 3D модели/rectangular/female/vertical/2.54mm/Samtec/SDL-104-TT-10.stp
Altium/3D models/Разные 3D модели/rectangular/female/vertical/2.54mm/Samtec/SDL-104-TT-11.stp
Altium/3D models/Разные 3D модели/rectangular/female/vertical/2.54mm/Samtec/SDL-104-TT-19.stp
Altium/3D models/Разные 3D модели/rectangular/female/vertical/2.54mm/Samtec/SDL-105-TT-10.stp
Altium/3D models/Разные 3D модели/rectangular/female/vertical/2.54mm/Samtec/SDL-105-TT-11.stp
Altium/3D models/Разные 3D модели/rectangular/female/vertical/2.54mm/Samtec/SDL-105-TT-12.stp
Altium/3D models/Разные 3D модели/rectangular/female/vertical/2.54mm/Samtec/SDL-105-TT-19.stp
Altium/3D models/Разные 3D модели/rectangular/female/vertical/2.54mm/Samtec/SDL-106-TT-10.stp
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
