Shitovdm/diploma/other/kis rpi/LIST 1.pdf

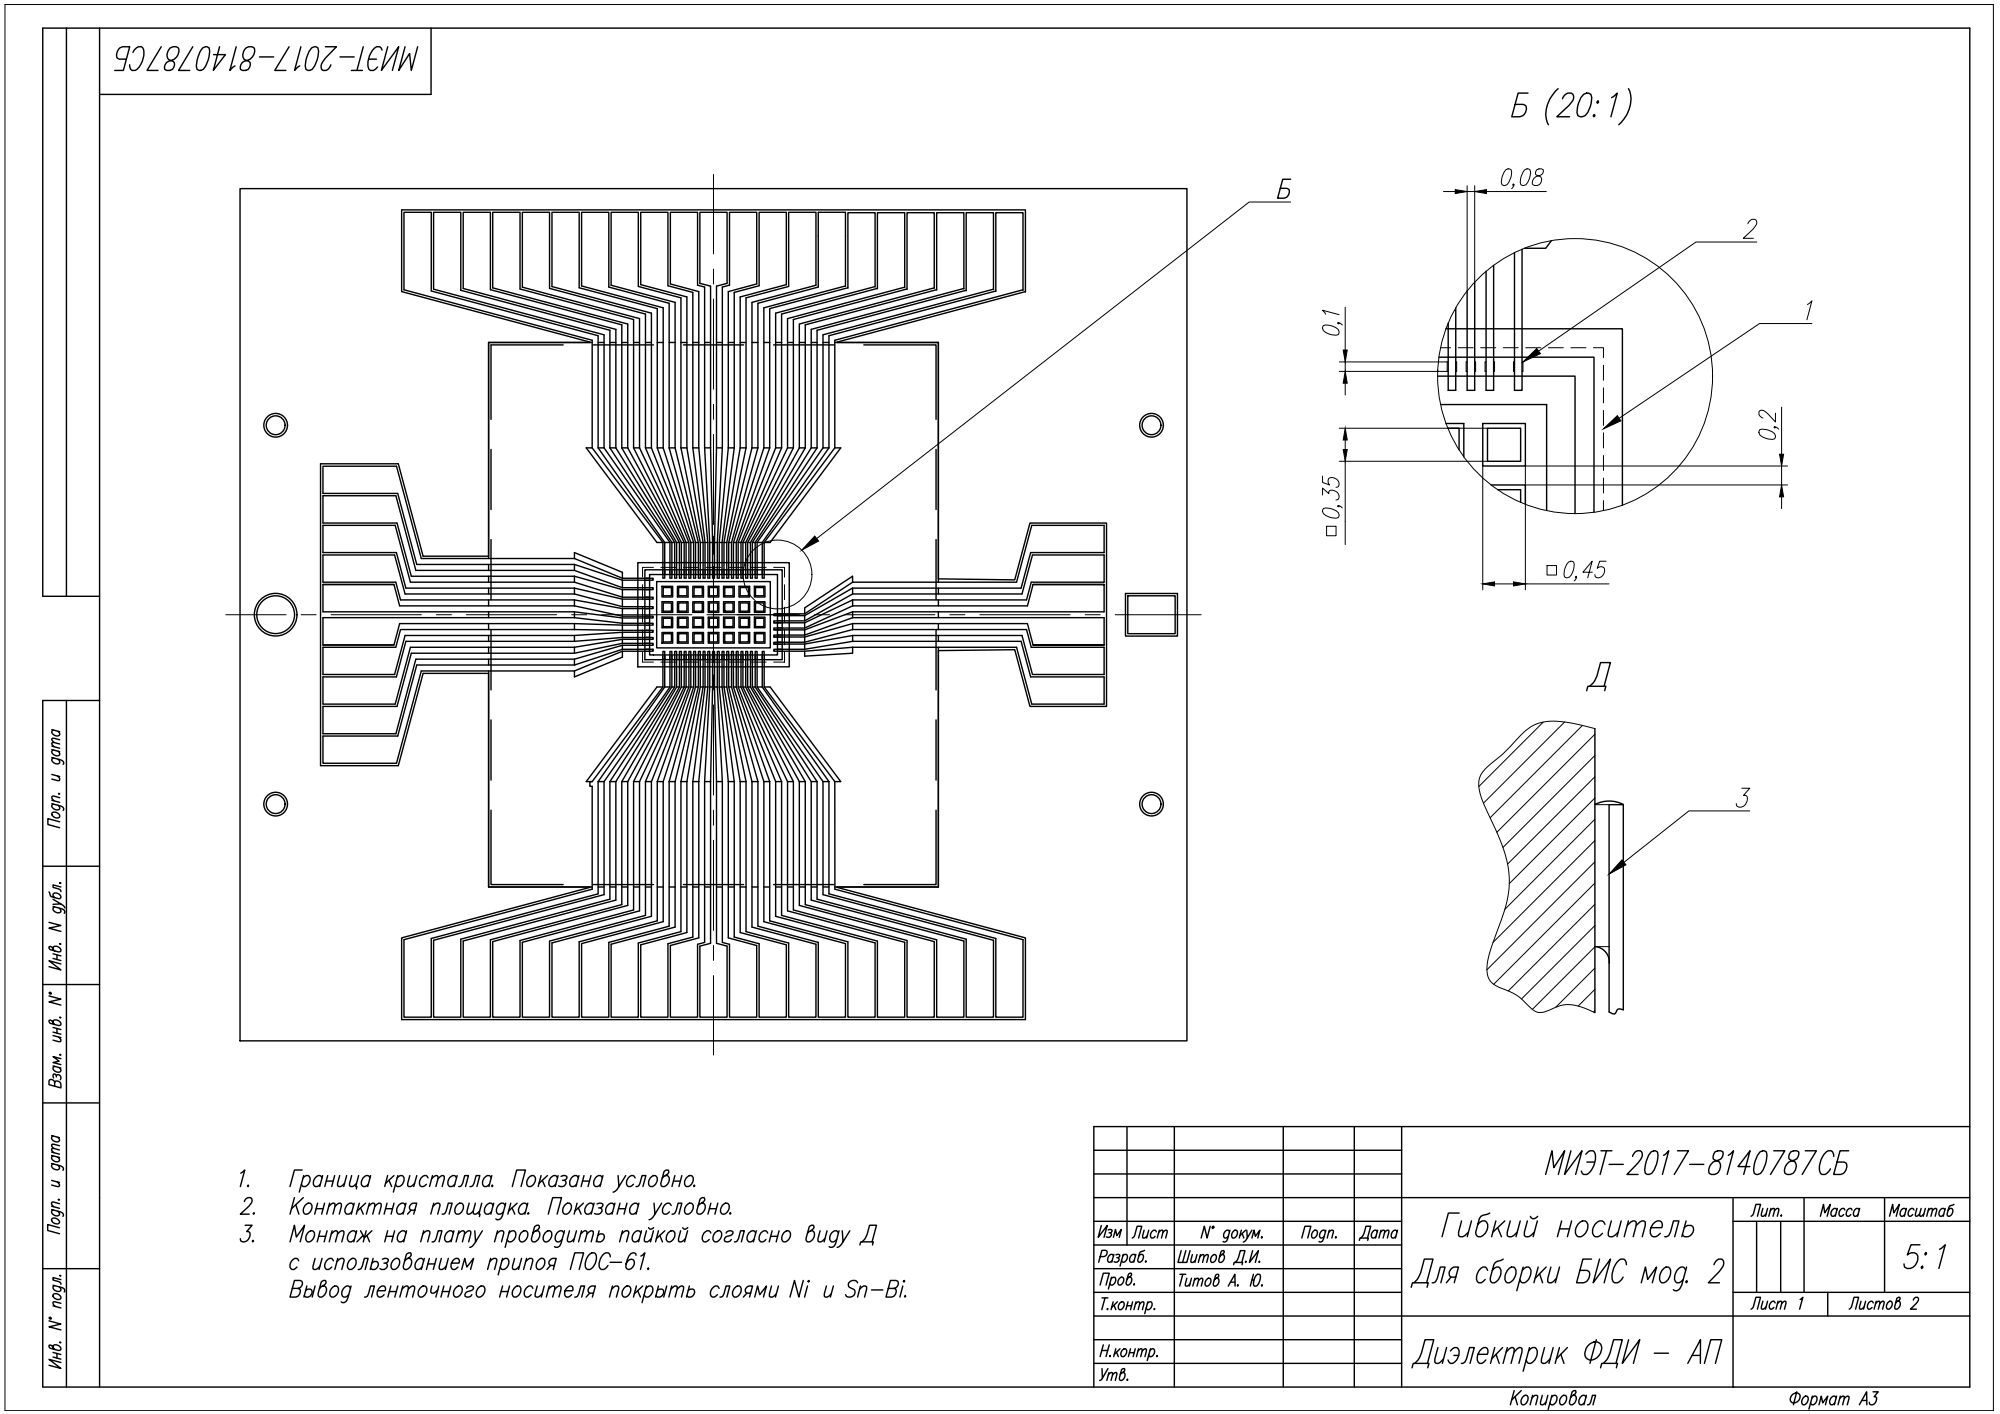
[picture p241: page 1]
