Shitovdm/diploma/other/kis rpi/LIST 2.pdf

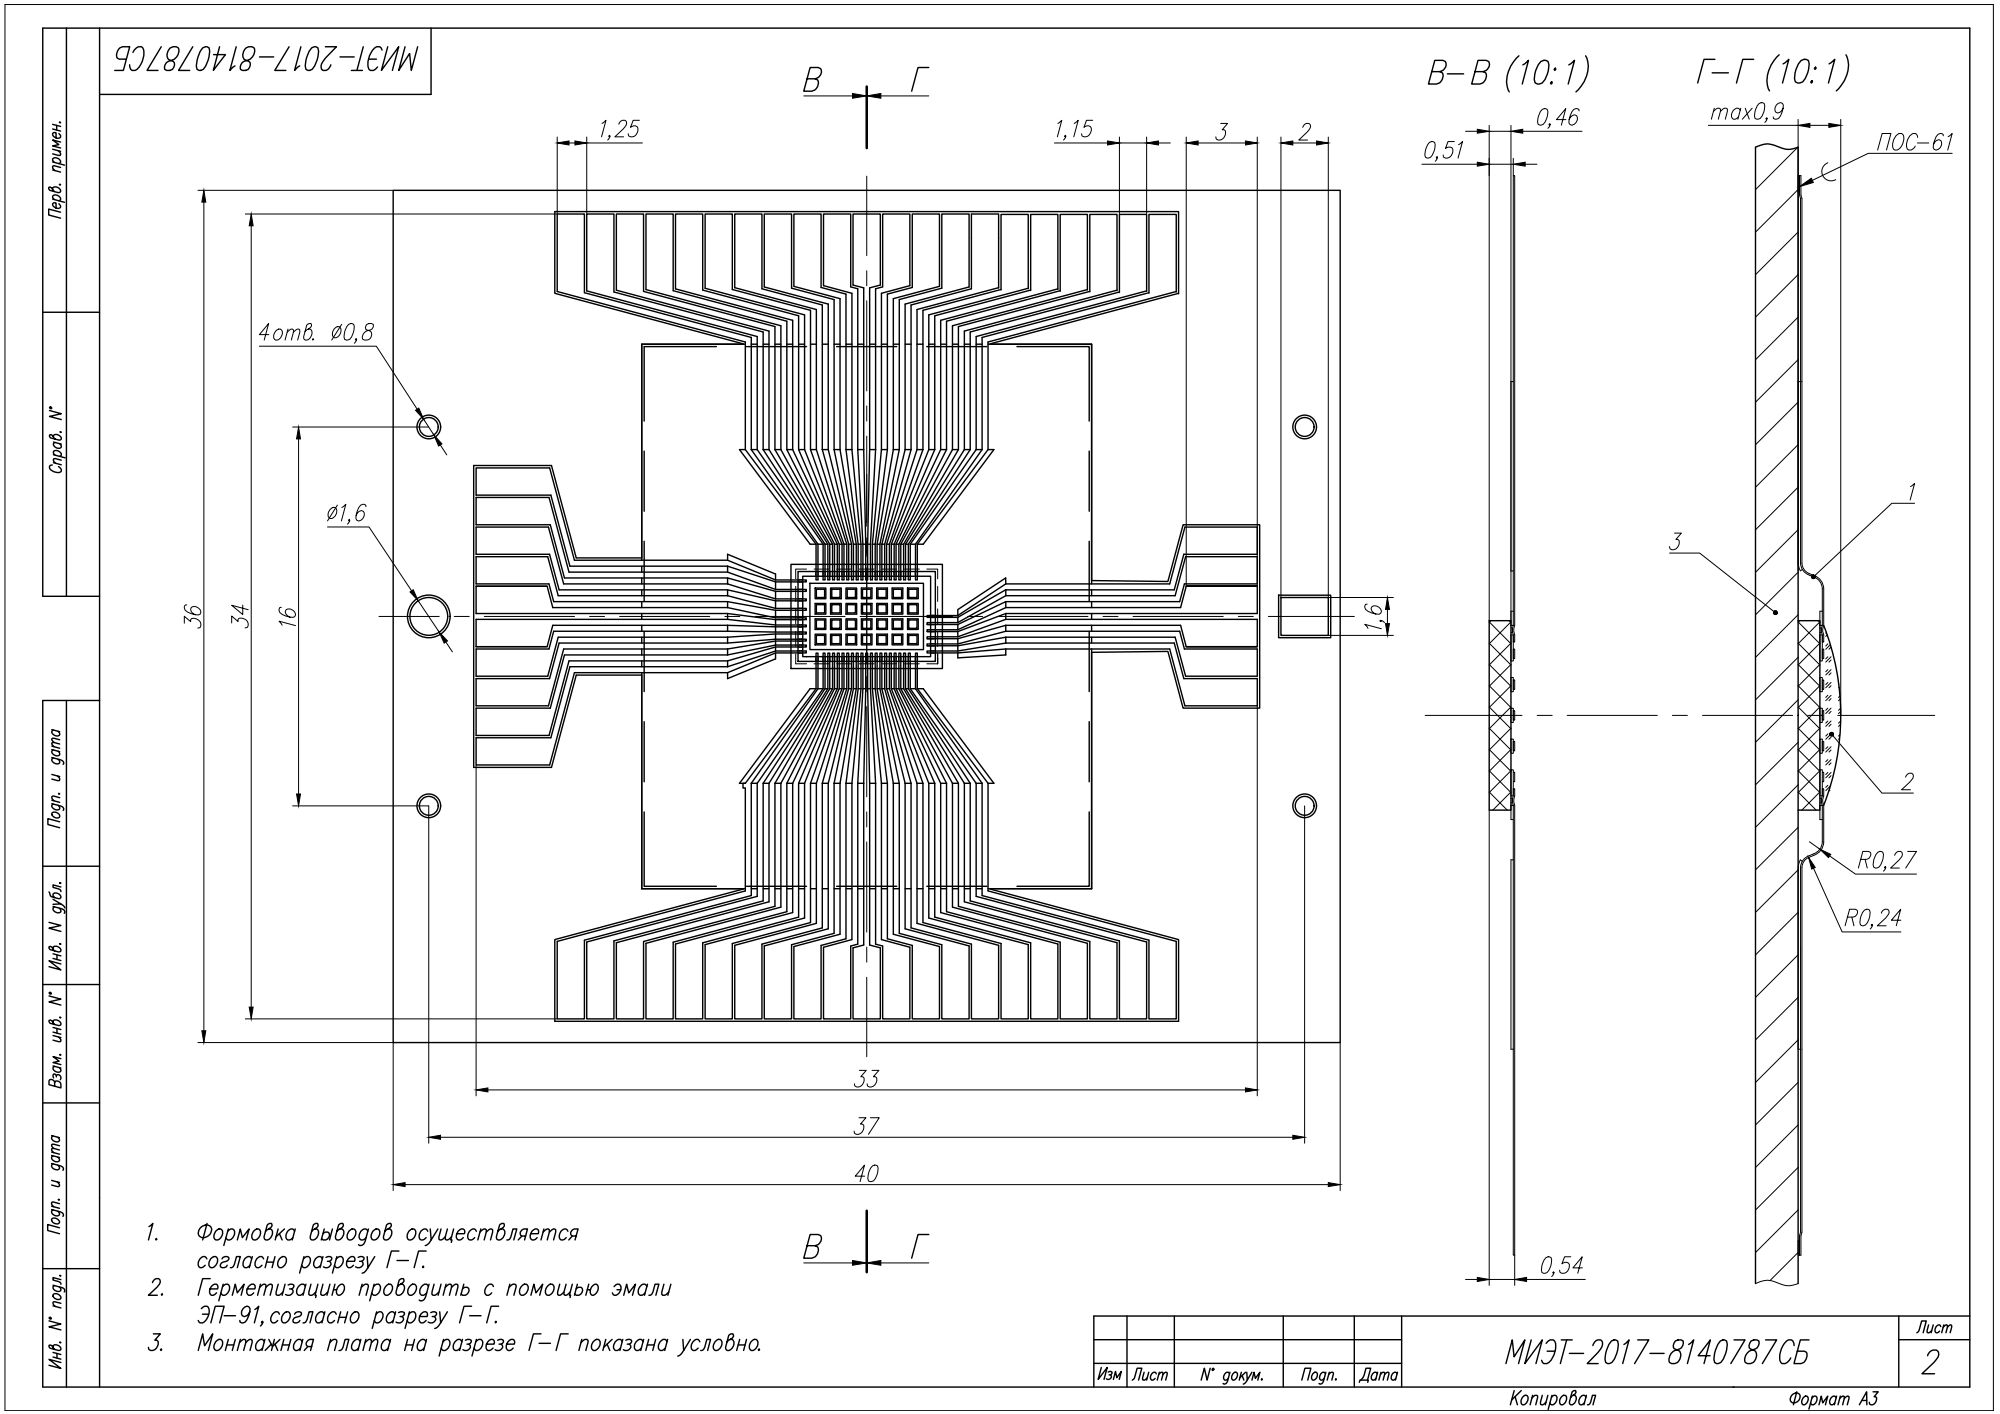
[picture p242: page 1]
