Shitovdm/diploma/other/kis rpi/LIST 3.pdf

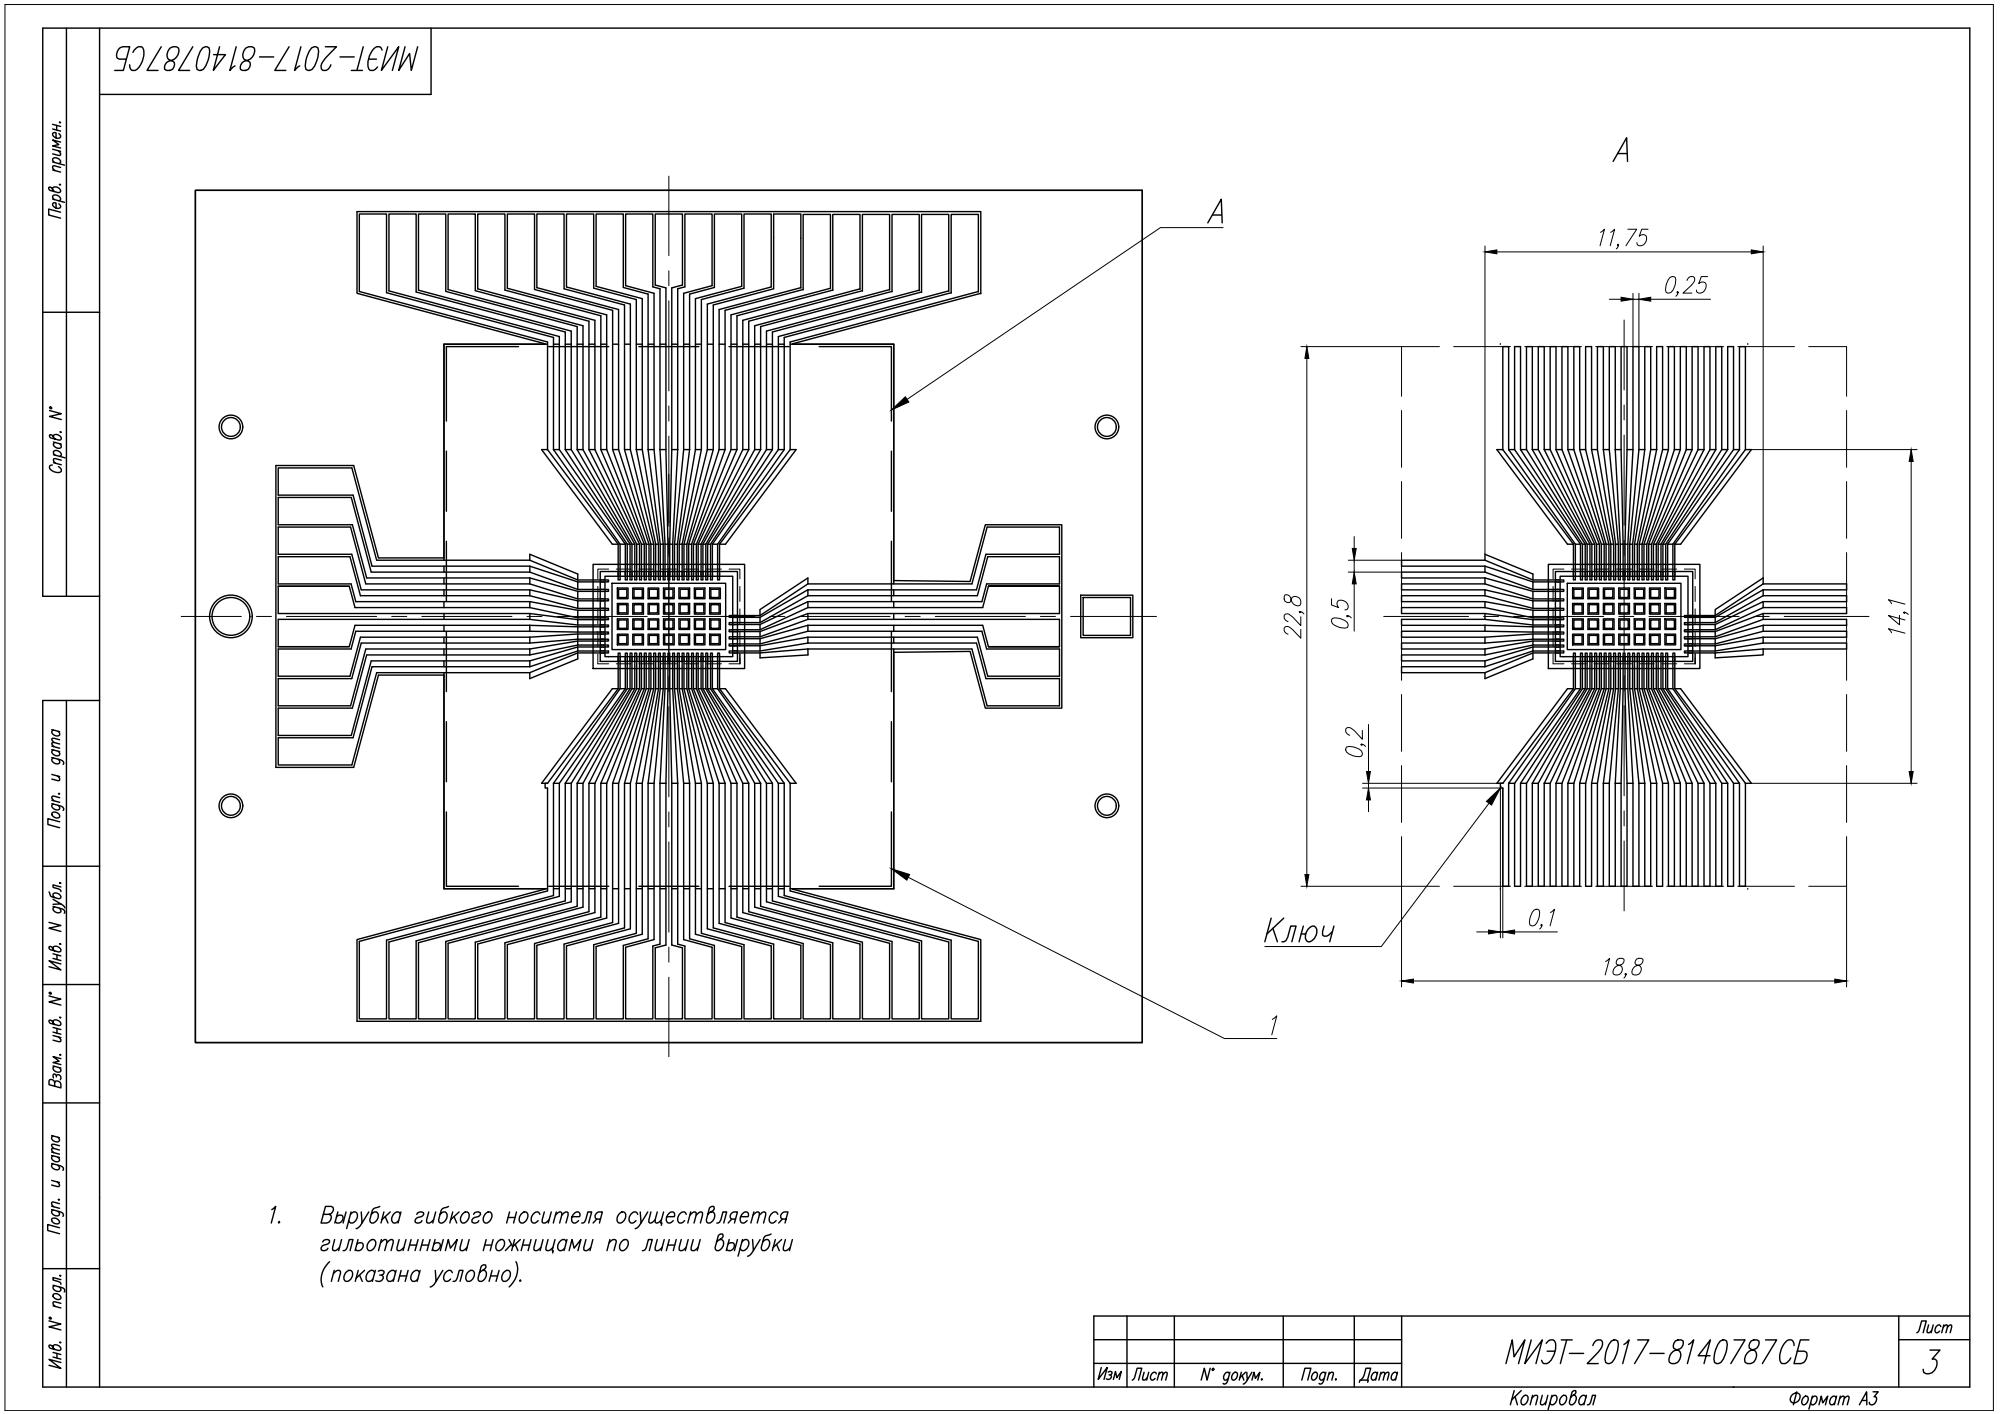
[picture p243: page 1]
