Shitovdm/diploma/(list of files, drawings)

Other design files:
Altium/diploma/Board.PcbDoc
Altium/diploma/diploma.PrjPcb
Altium/diploma/giro-stable.SchLib
Altium/diploma/gyro-stable.PcbLib
Altium/diploma/PCB1.PcbDoc
Altium/diploma/PCB2.PcbDoc
Altium/diploma/Scheme.SchDoc
Altium/diploma/Sheet1.SchDoc
Altium/diploma/ЭЗ.SchDoc
