Shitovdm/diploma/(commit log)

2017-12-06 Diploma project.
    [3224X.stp, 3528 SMD LED.stp, Board.PcbDoc, CAPAE-D10.0x10.2.stp, CAPAE-D4.0x5.4.stp, CAPAE-D5.0x5.4.stp, CAPAE-D6.3x5.4.stp, CAPAE-D8.0x10.2.stp]
2017-12-07 Changes 2.
    [Board.PcbDoc, Scheme.SchDoc, diploma.PrjPcb, giro-stable.SchLib, gyro-stable.PcbLib]
2017-12-08 Changes 3.
    [DS1022-1x2RD61.stp, PCB1.PcbDoc, Scheme.SchDoc, diploma.PrjPcb, giro-stable.SchLib, gyro-stable.PcbLib]
2017-12-09 Changes 4.
    [PCB1.PcbDoc, PCB2.PcbDoc, QFN-28 5x5mm.stp, Scheme.SchDoc, Scheme.dwg, TO-253AA.stp, diploma.PrjPcb, giro-stable.SchLib]
2017-12-10 Changes 5.
    [ESKD_A2h1.dwg, ESKD_A2h2.dwg, ESKD_A2v1.dwg, ESKD_A2v2.dwg, ESKD_A3h1.dwg, ESKD_A3h2.dwg, ESKD_A3v1.dwg, ESKD_A3v2.dwg]
2017-12-12 Changes 6.
    [SB.dwg, Структурная схема.dwg]
2017-12-20 Changes 11.
    [ALGO.dwg]
2019-08-22 Added found files.
    [3224X.stp, 3528 SMD LED.stp, ALGO.dwg, Board.PcbDoc, CAPAE-D10.0x10.2.stp, CAPAE-D4.0x5.4.stp, CAPAE-D5.0x5.4.stp, CAPAE-D6.3x5.4.stp]
